KingBBQ/searchwingDronebuldingDoc/maintenance/hardware.md

# Hardware

## Motor

## Propeller

## Battery
