KingBBQ/searchwingDronebuldingDoc/using-the-drone/after-flight.md

# After-Flight

## 1. Download Images

After the plane is landed, you should immediatly start downloading the images to the groundstation laptop through the image download station.

1. Start by pressing "Download Drone images" on Groundstation Laptop
2. Enter dronename - here "perlman"
3. Leave cam prefix empty
4. Two windows should appear - each for one camera / pi in the plane
5. Approximatly 1 image download should take 1-2 seconds.

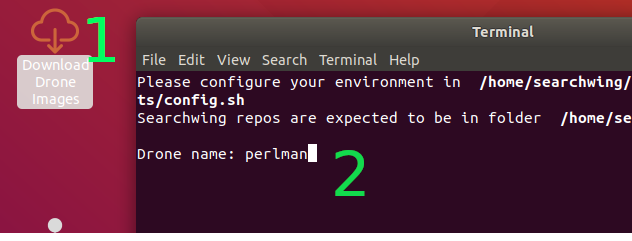
[picture p17: .gitbook/assets/image (8).png]


## 2. Image analysis

While image download is running, start analysis of the images while they get downloaded.

* There are different algorithms available to analyse the images 
  * Classify Images: Shows whether a image includes a boat but not where it is
    * EfficientNet
  * Detect Boats: Shows where in the image a boat is located
    * FRCNN
    * RetinaNet

{% hint style="info" %}
Be aware that only one analysis run / algorithm can run at a time - please close all open old analysis runs!
{% endhint %}

### Start analysis

1. Start analysis by clicking the corresponding desktop icon
2. Choose the currently downloaded images of the plane according to planename and timestamp from _/home/searchwing/flightdata/_
3. Press "OK"
4. All current and live added images to the folder will now be processed
5. Current progress and left over time can be observed

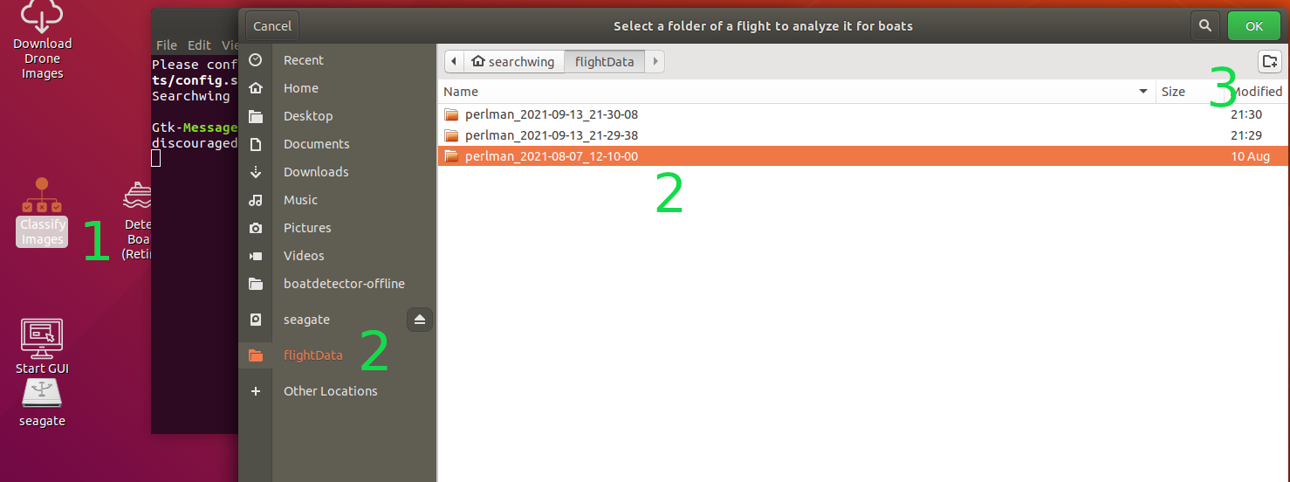
[picture p18: .gitbook/assets/image (16).png]


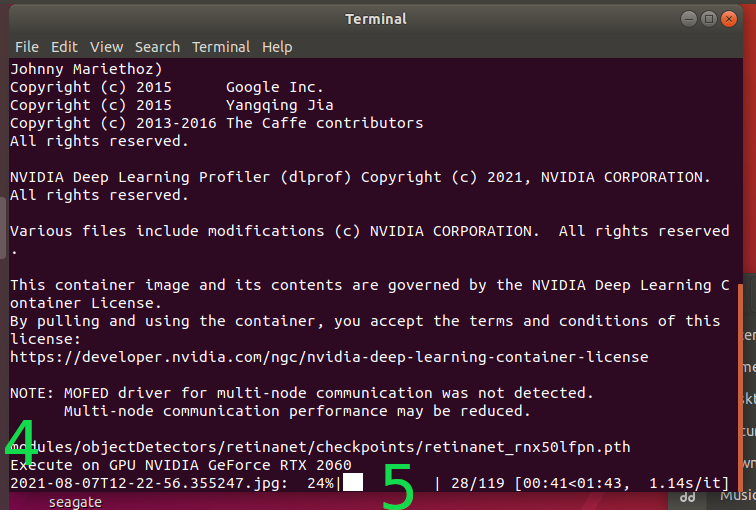
[picture p19: .gitbook/assets/image (12).png]


### Suggestion on how to process on new flight data \(Best practice!\)

1. Start "Image Classification" as it is the fastest algorithm
2. Wait until Download and classification is finished and close "Image Classification" 

   window

3. Start "Detect Boats \(Retina\)" as its more accurate than classification but takes longer

## 3. Observe images

While the download and the analysis is running you should now observer the images and the analysis results by using the searchwing-gui.

1. Start GUI via desktop icon - The browser should open
2. Select / click the currently downloaded image data
3. Read "Help" to get more usability info

   1. Use Arrowkeys to browse images
   2. Sort images using "DateTime" or "Algorithm"
   3. Press "Shift"-Key to temporarily hide Analysis Run Boxes
   4. Press "Enter"-Key to mark image as viewed and go to next image
   5. Press "Space"-Key to mark image as interesting / that there is REALLY a boat
   6. Current GPS Position is shown in the top bar
   7. Press "&lt;back" to choose a different flight dataset

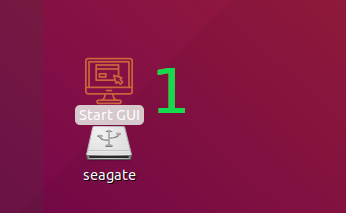
[picture p20: .gitbook/assets/image (7).png]


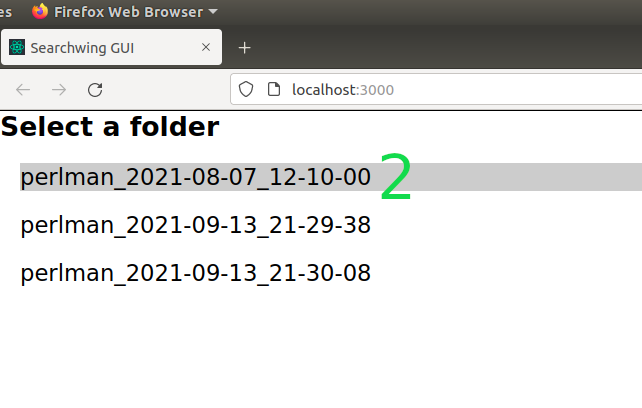
[picture p21: .gitbook/assets/image (9).png]


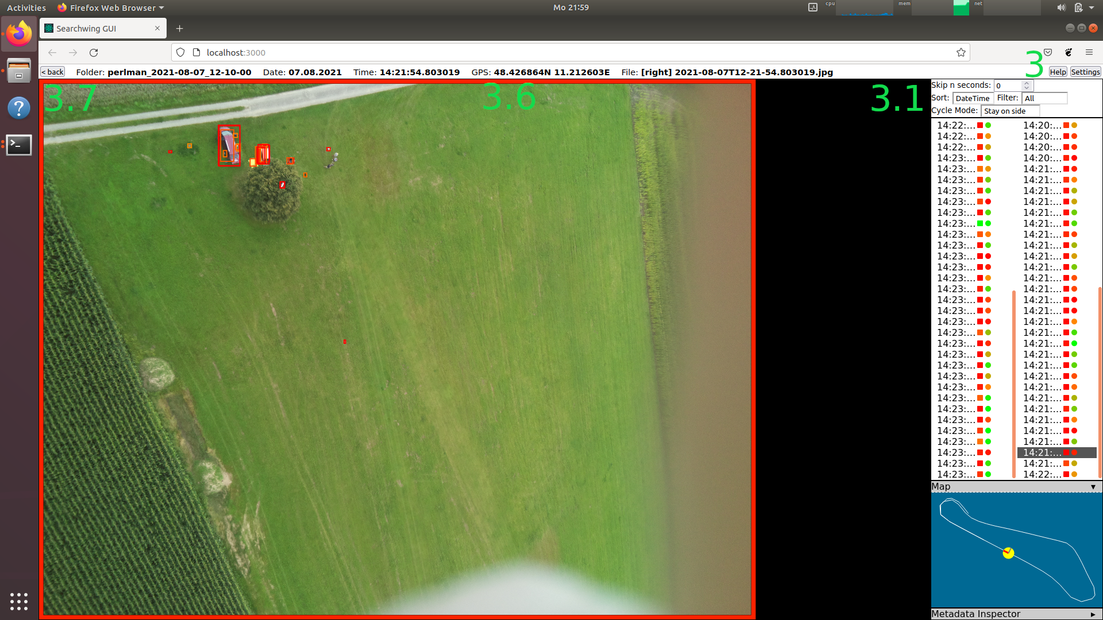
[picture p22: .gitbook/assets/image (14).png]


{% hint style="info" %}
If the GUI is already running and you try to open it up again a message will appear wheather you want to open the GUI at another port. Dont press "Y" but instead open the browser and open the GUI via typing in "localhost:3000".
{% endhint %}

## 4. Recharge Battery

* [ ] Plug in charging cable
* [ ] Use predefined setting for the drone

## \(optional\) Download pi log file

* [ ] Download the pi log file\(s\) via scp

```bash
$ mkdir -p /home/searchwing/flightdata/FLIGHTNAME/pi-logs
$ cd /home/searchwing/flightdata/FLIGHTNAME/pi-logs
$ scp searchwing@perlman-l:/data/logs/* .
```

## 5. Turn off systems

* [ ] UAV / drone
* [ ] Remote control
* [ ] QGC / tablet
* [ ] TODO

## 6. Documentation

* [ ] Get flight log / book
* [ ] Is goal reached?
* [ ] TODO

## \(optional\) Cleaning the drone

{% hint style="info" %}
If drone is not used anymore within the next hours cleaning is needed!
{% endhint %}

### Clean motor using sweetwater

* TODO
