KingBBQ/searchwingDronebuldingDoc/.gitbook/assets/bending_tube_wires.jpeg

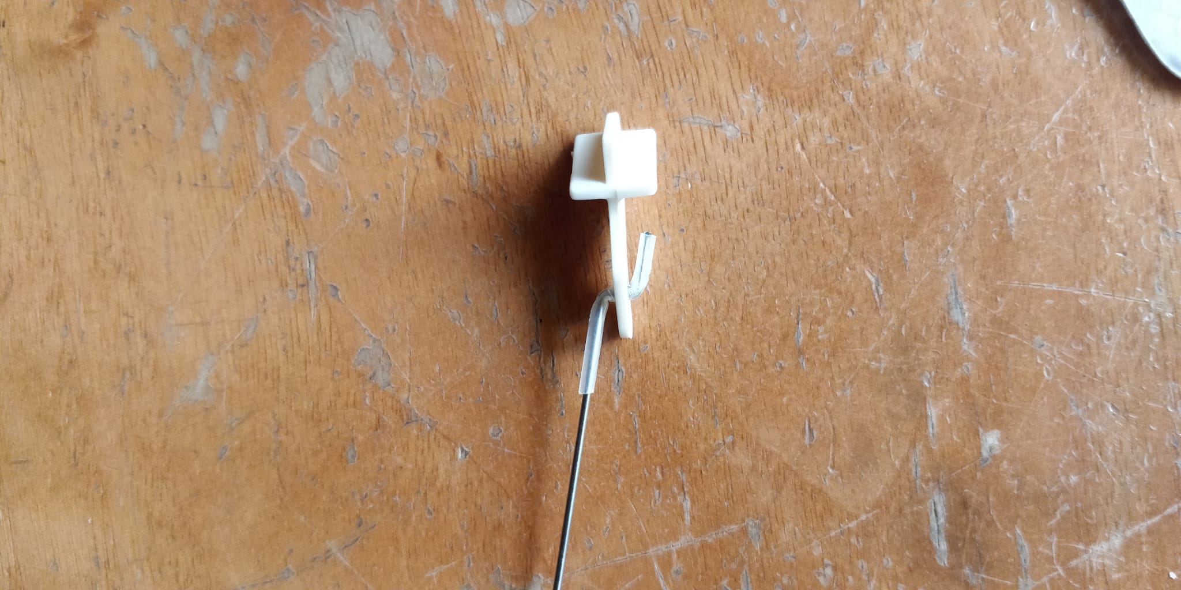
.gitbook/assets/bending_tube_wires.jpeg
