KingBBQ/searchwingDronebuldingDoc/.gitbook/assets/cutting_vtail.jpeg

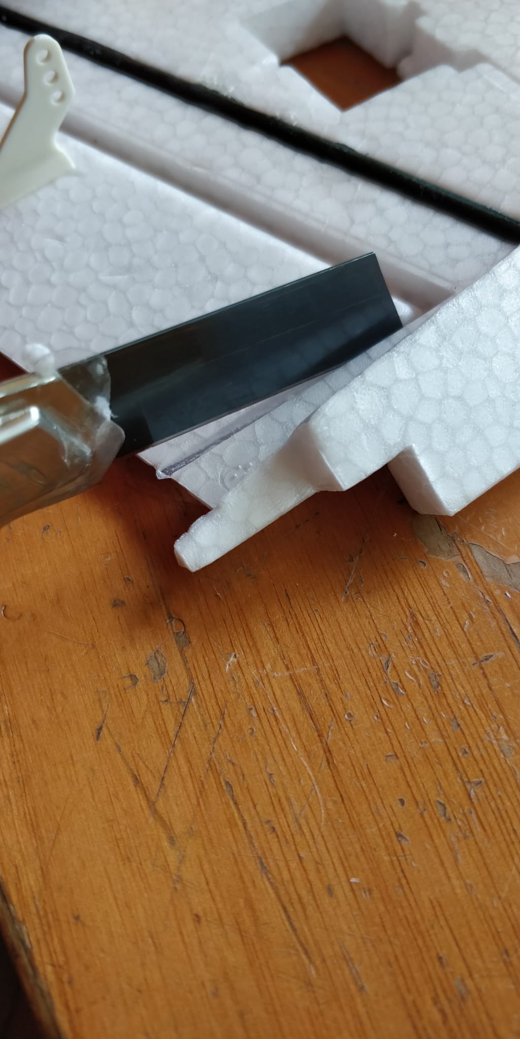
.gitbook/assets/cutting_vtail.jpeg
