KingBBQ/searchwingDronebuldingDoc/.gitbook/assets/gps_tower_1 (1).jpeg

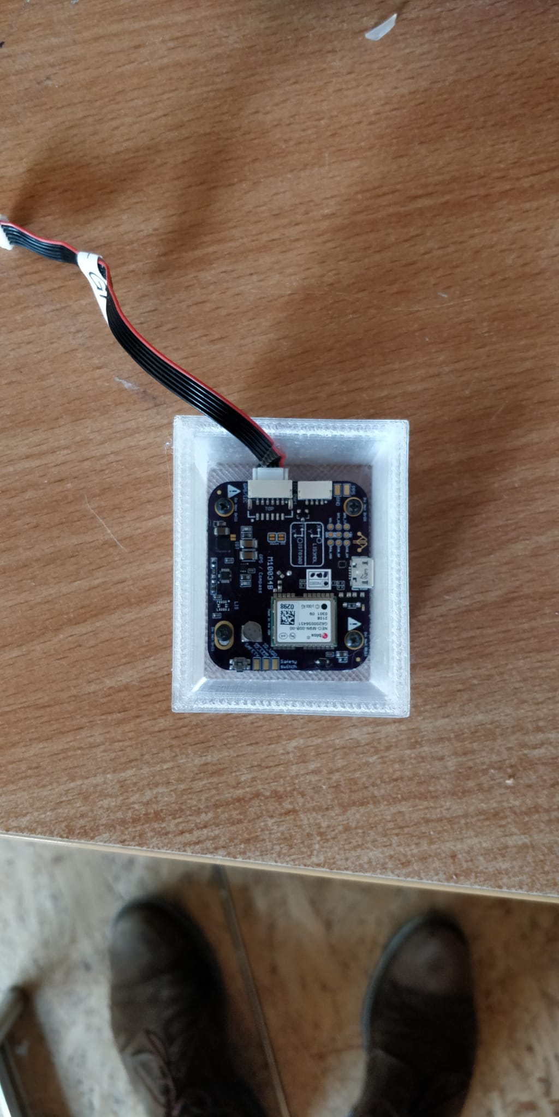
.gitbook/assets/gps_tower_1 (1).jpeg
