KingBBQ/searchwingDronebuldingDoc/.gitbook/assets/gps_tower_4.jpeg

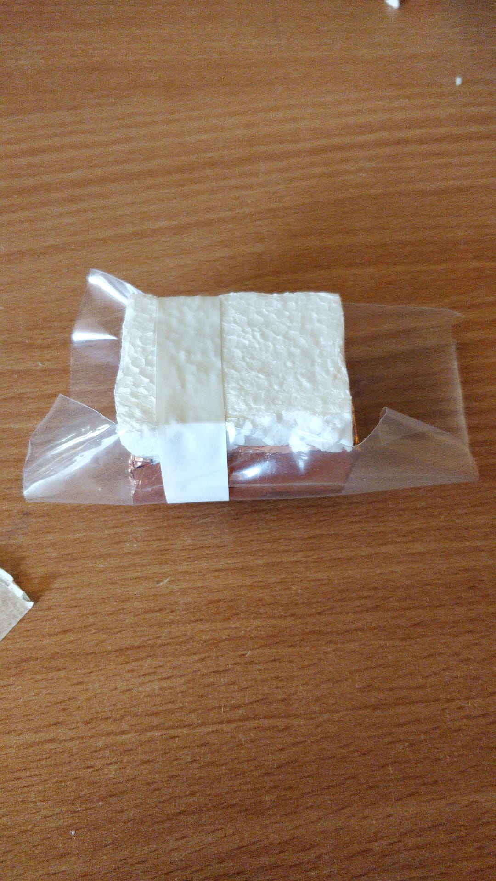
.gitbook/assets/gps_tower_4.jpeg
