KingBBQ/searchwingDronebuldingDoc/.gitbook/assets/image (17).png

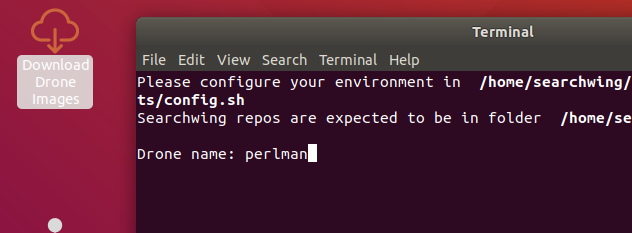
.gitbook/assets/image (17).png
