KingBBQ/searchwingDronebuldingDoc/.gitbook/assets/img_20210607_140835.jpg

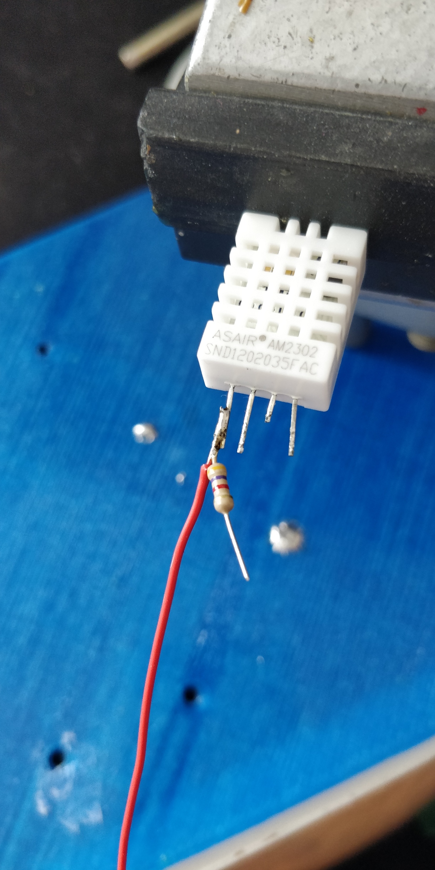
.gitbook/assets/img_20210607_140835.jpg
