KingBBQ/searchwingDronebuldingDoc/.gitbook/assets/img_20210607_141408.jpg

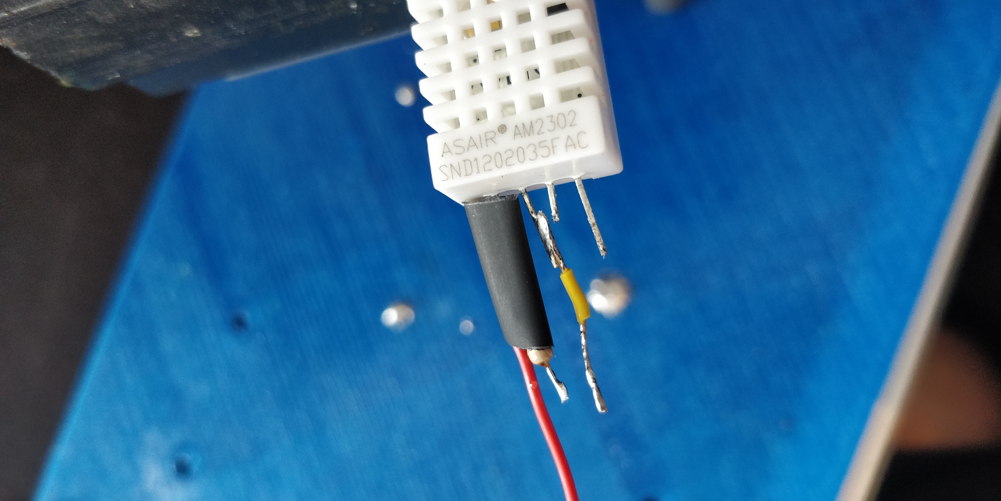
.gitbook/assets/img_20210607_141408.jpg
