KingBBQ/searchwingDronebuldingDoc/.gitbook/assets/img_20210607_141638.jpg

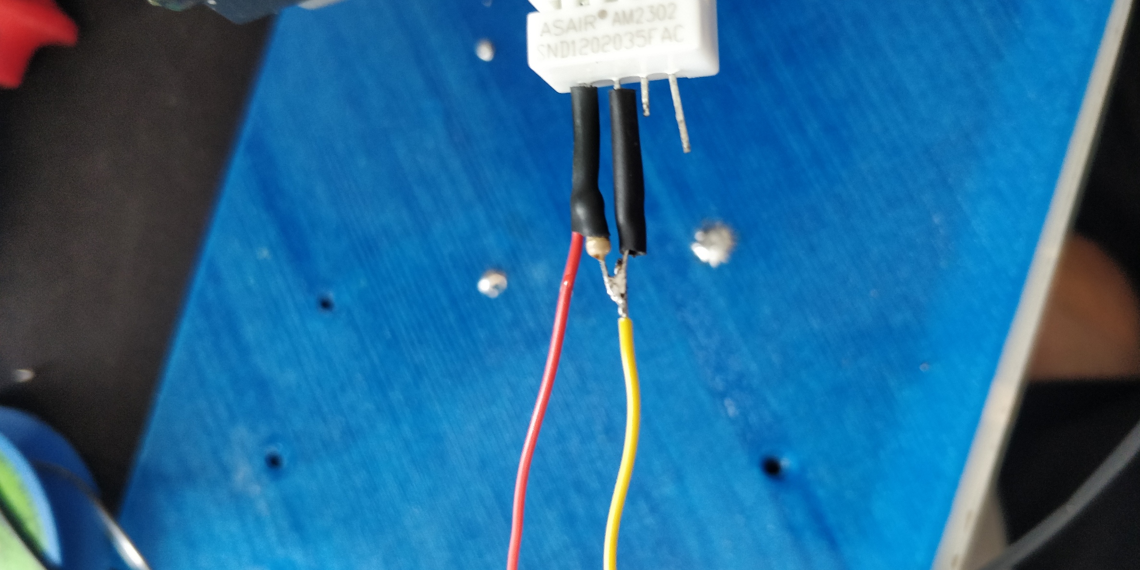
.gitbook/assets/img_20210607_141638.jpg
