KingBBQ/searchwingDronebuldingDoc/.gitbook/assets/img_20210607_142049.jpg

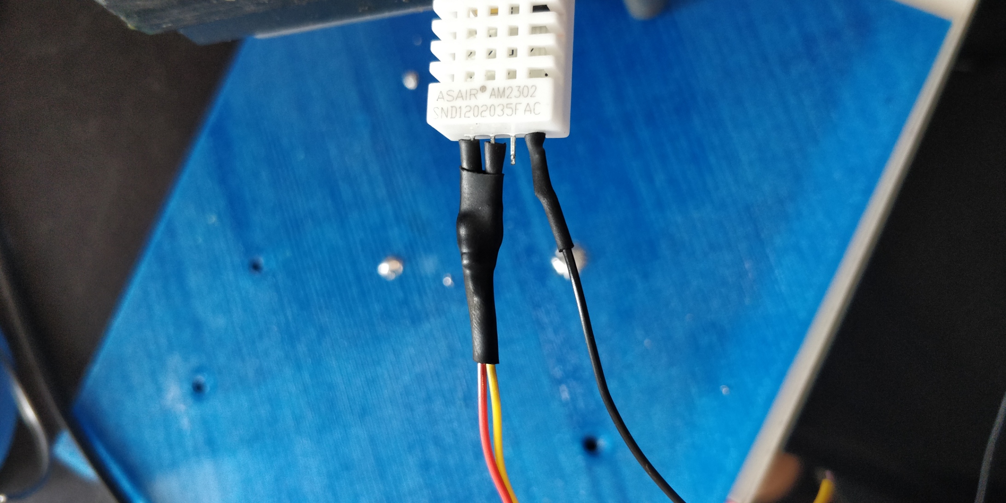
.gitbook/assets/img_20210607_142049.jpg
