KingBBQ/searchwingDronebuldingDoc/Photos/Cables/PowerModule 4.jpg

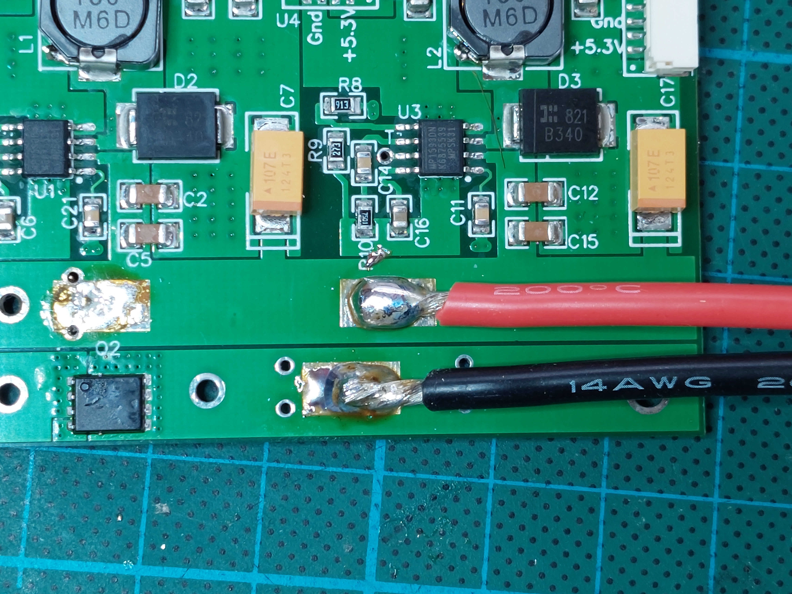
Photos/Cables/PowerModule 4.jpg
