KingBBQ/searchwingDronebuldingDoc/Photos/Schematics/PixRacer.png

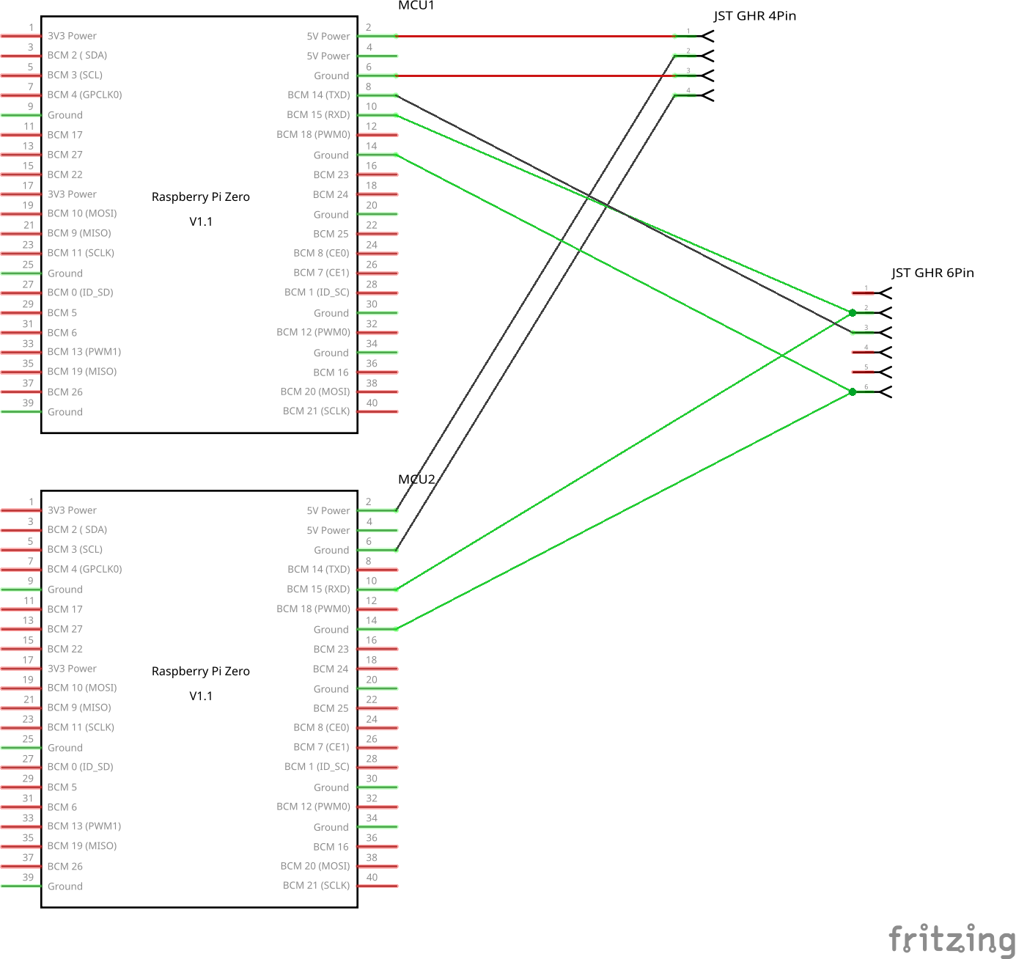
Photos/Schematics/PixRacer.png
