KingBBQ/searchwingDronebuldingDoc/preparing-components/combining-components/equipping-the-box-with-all-components.md

# Equipping the box with all components

#### Time required

* **Building:** 1 hour
* **Curing**: 2 days

#### Tools required

* Loctice 243
* 9mm wrench

#### Parts required

* all elecronic parts
* front and back of box
* cover for box
* screws 1.7mm x 4mm for camera
* ... 2.2mm x 6.5 for everything else
* Silicon 
* pen

## Step 1: Install the servo connectors



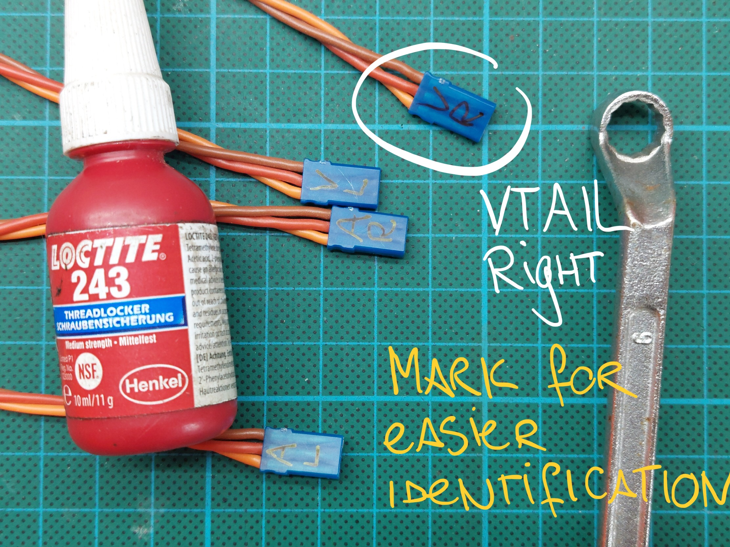
[picture p38: .gitbook/assets/m-plug-2.jpg]


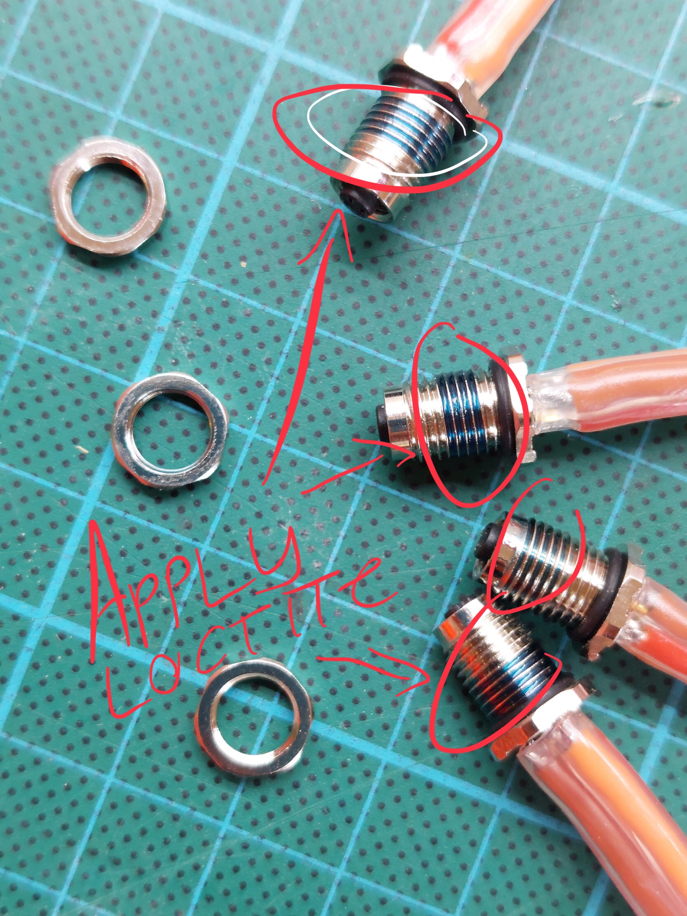
[picture p39: .gitbook/assets/m-plug-3.jpg]


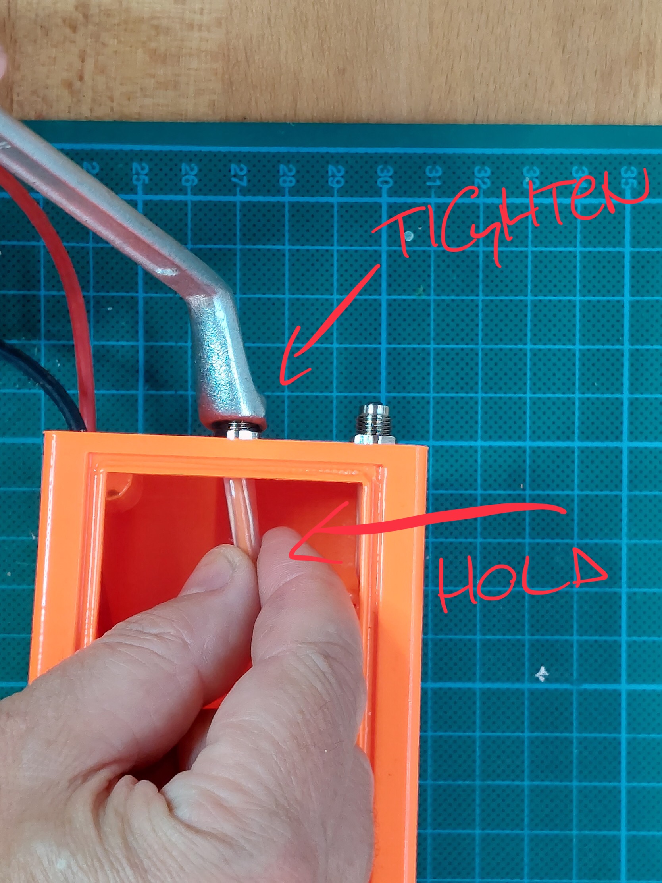
[picture p40: .gitbook/assets/m-plug-4.jpg]


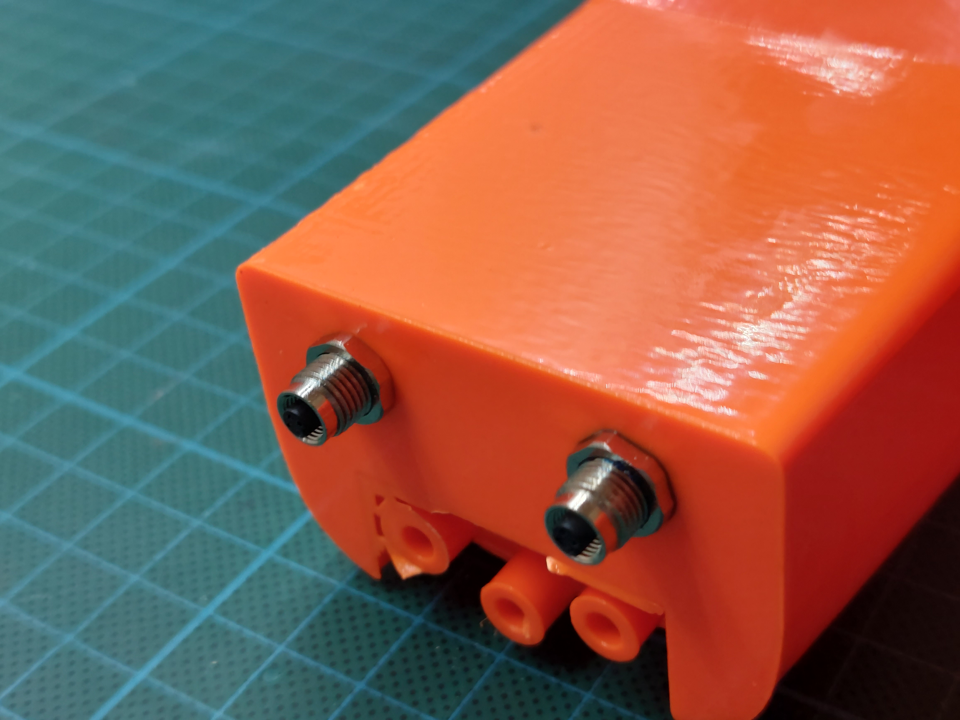
[picture p41: .gitbook/assets/m-plug-6.jpg]


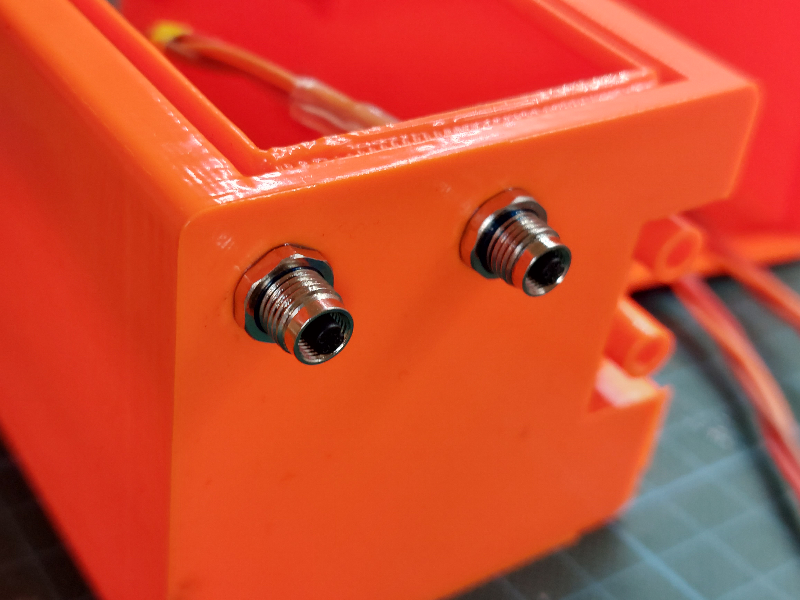
[picture p42: .gitbook/assets/m-plug-7.jpg]


{% hint style="info" %}
Give special instrucktion... 
{% endhint %}

## Step 2: Install Raspberry Pi and Camera

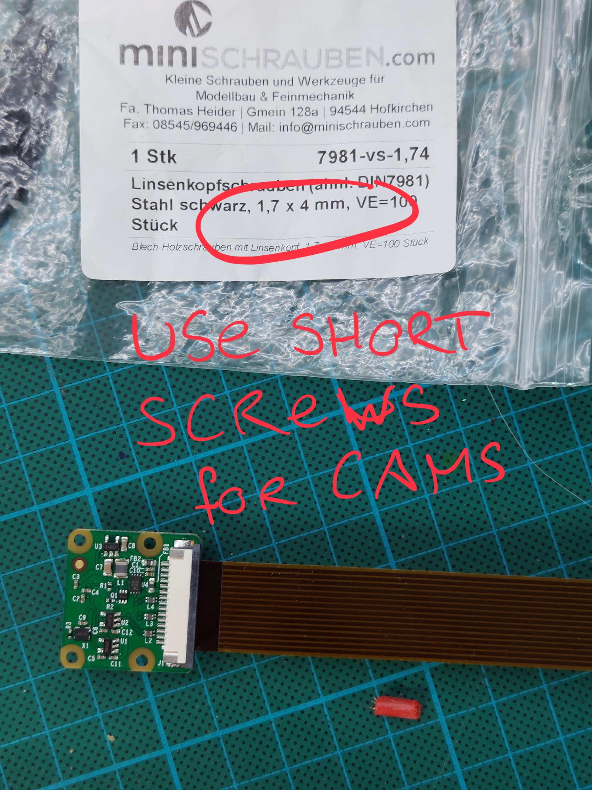
[picture p43: .gitbook/assets/picam-1.jpg]


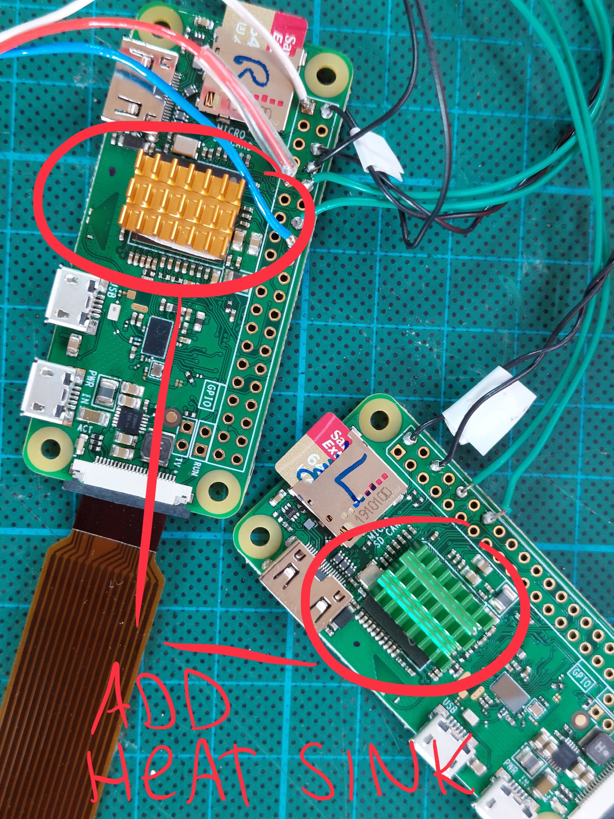
[picture p44: .gitbook/assets/picam-2.jpg]


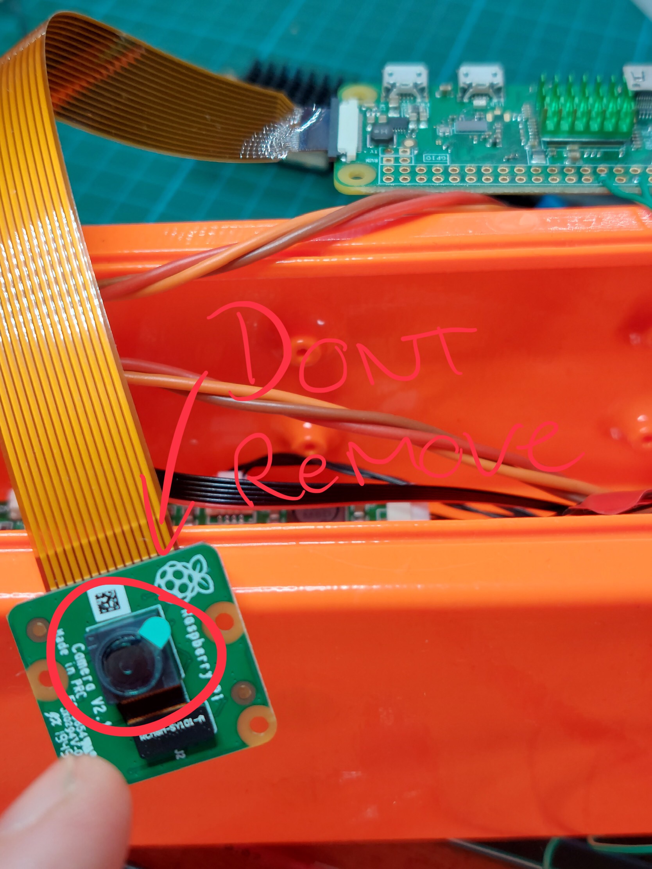
[picture p45: .gitbook/assets/picam-3.jpg]


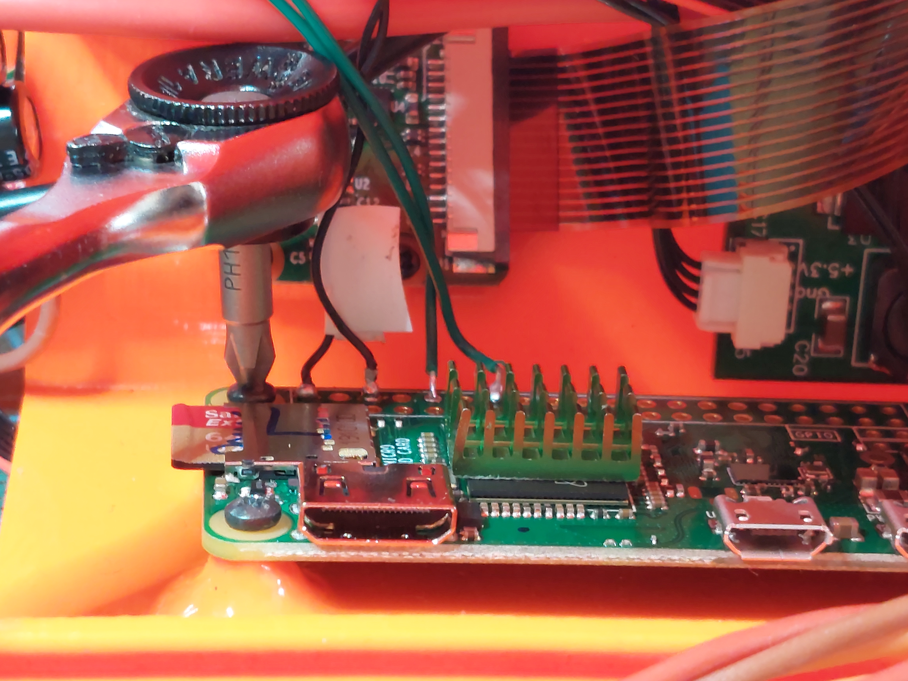
[picture p46: .gitbook/assets/picam-4.jpg]


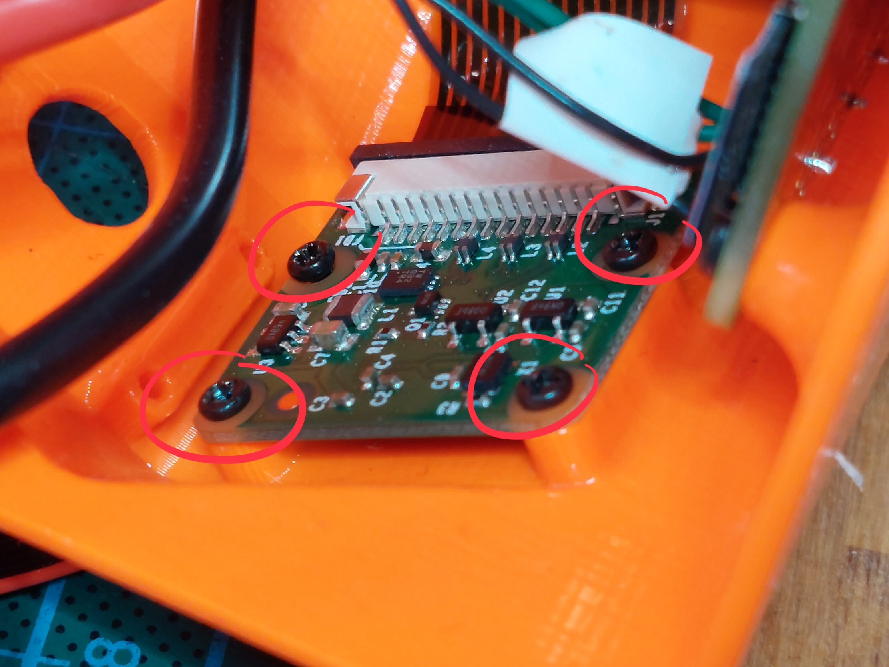
[picture p47: .gitbook/assets/picam-5.jpg]


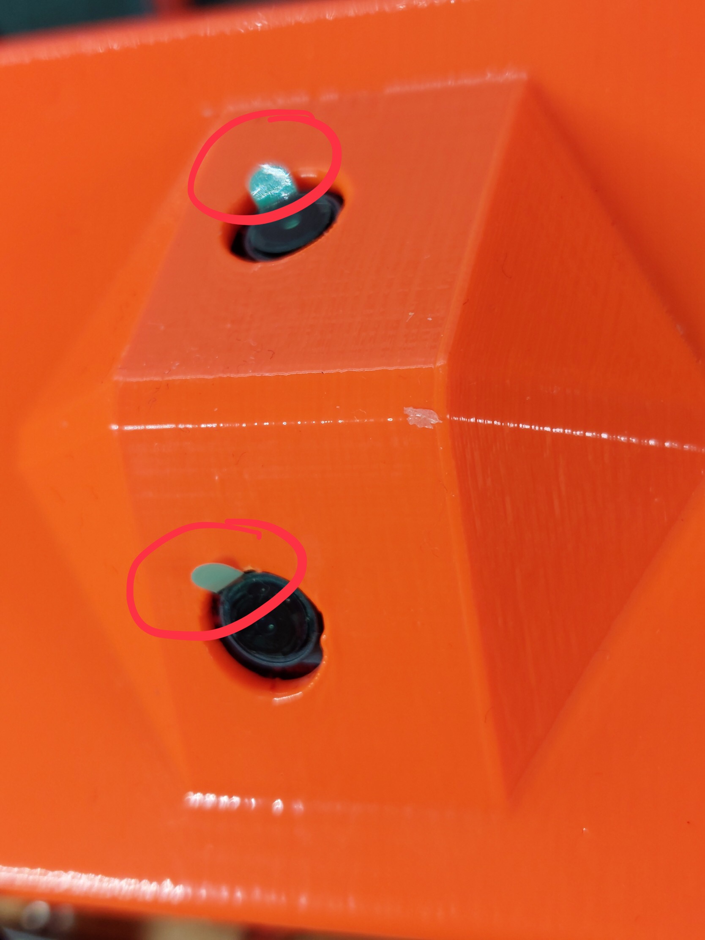
[picture p48: .gitbook/assets/picam-6.jpg]


## Step 3: Install the Power Module



## Step 4: Prepare the cover

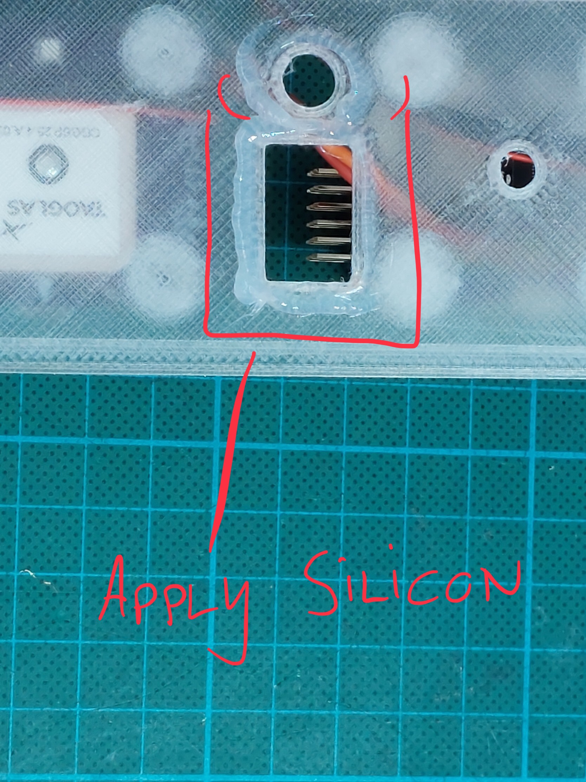
[picture p50: .gitbook/assets/cover-1.jpg]


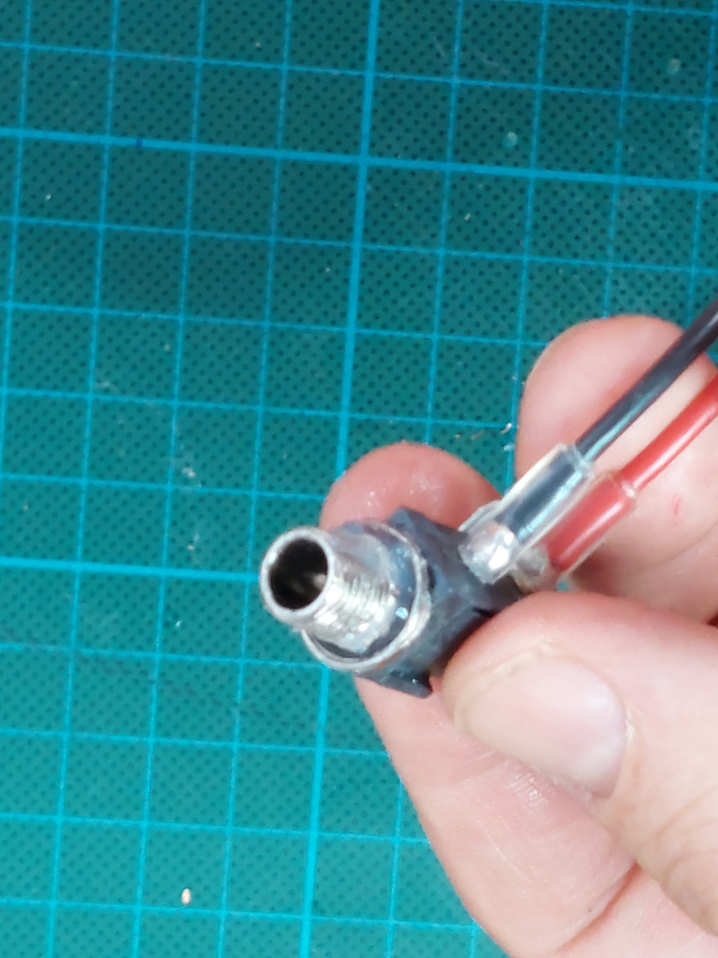
[picture p51: .gitbook/assets/cover-2.jpg]


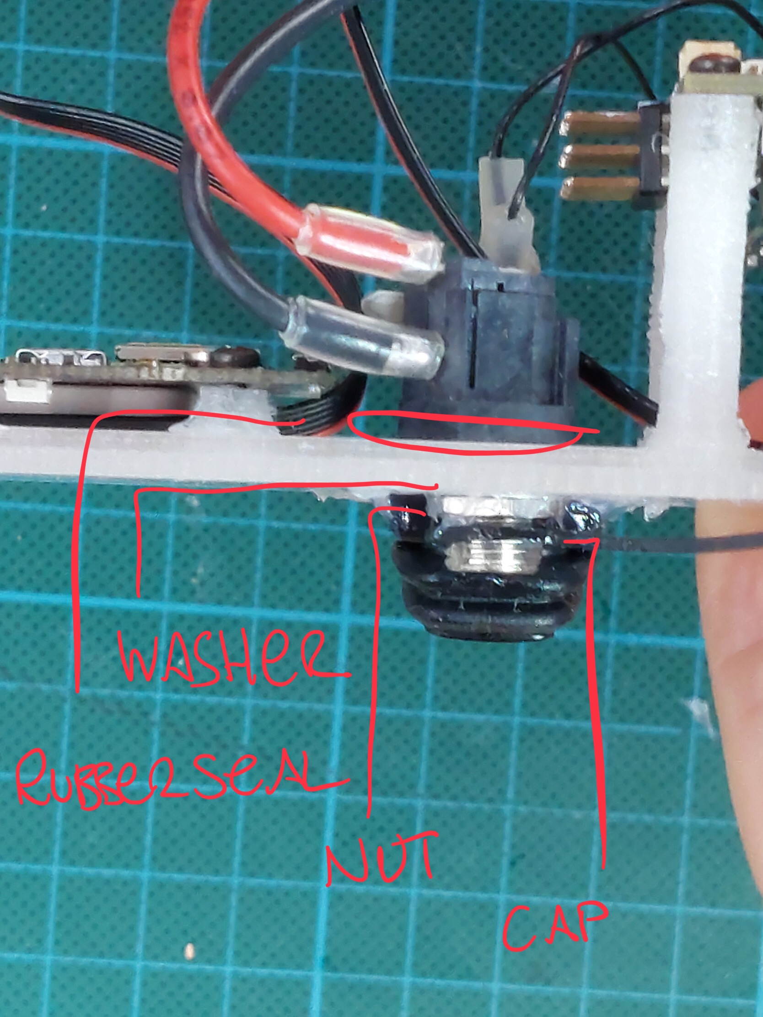
[picture p52: .gitbook/assets/cover-3.jpg]


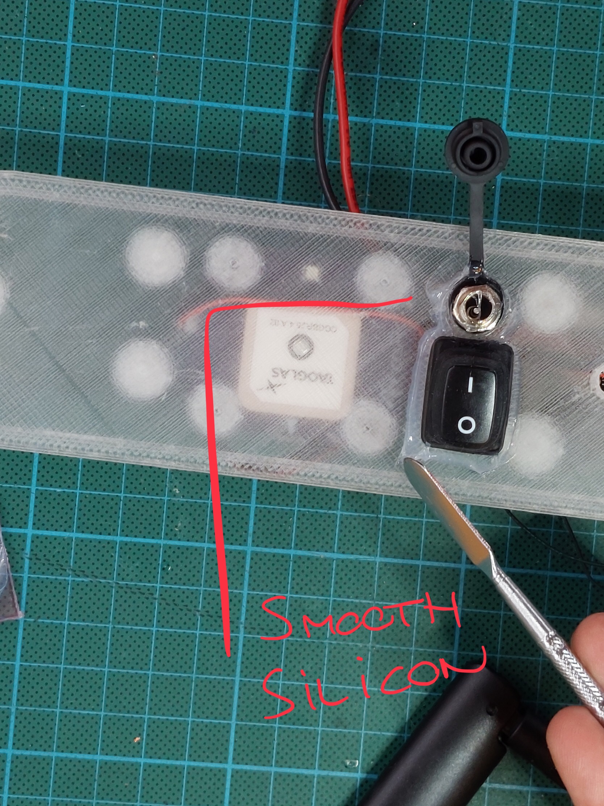
[picture p53: .gitbook/assets/cover-4.jpg]


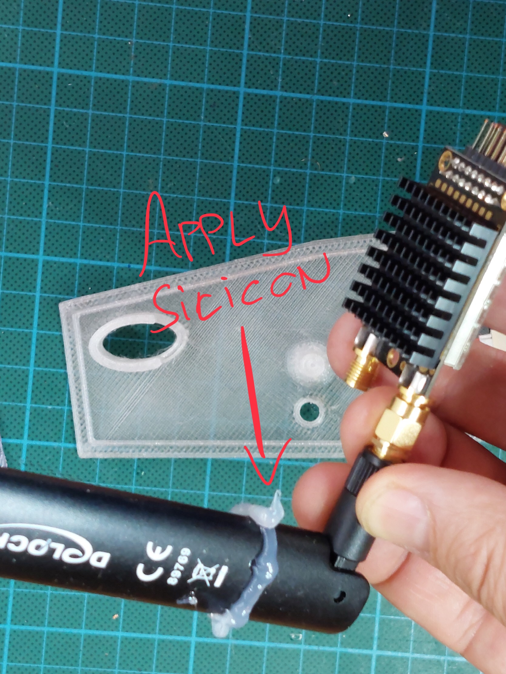
[picture p54: .gitbook/assets/cover-antenna-1.jpg]


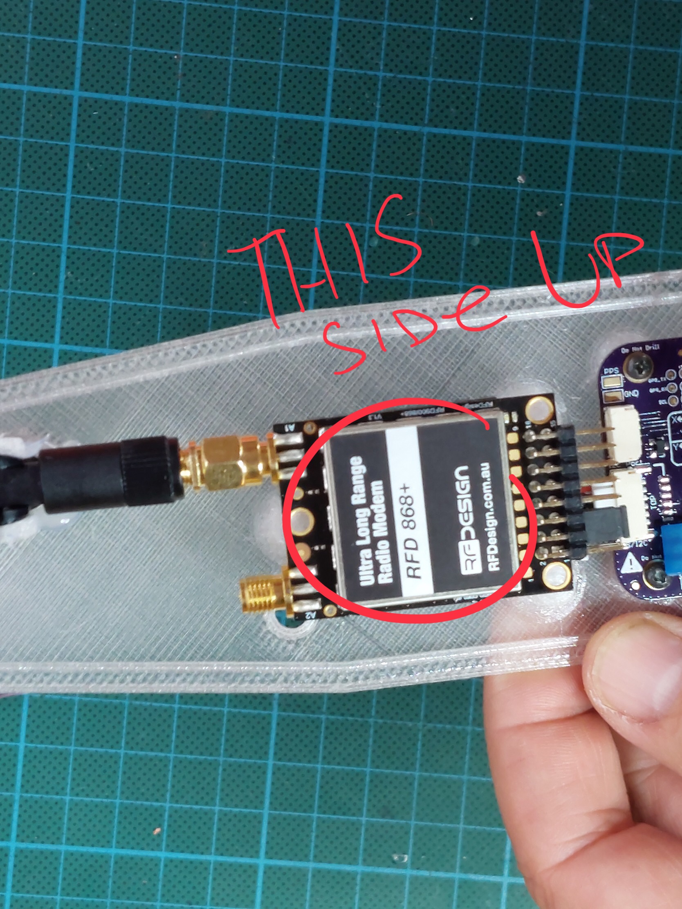
[picture p55: .gitbook/assets/cover-antenna-2.jpg]


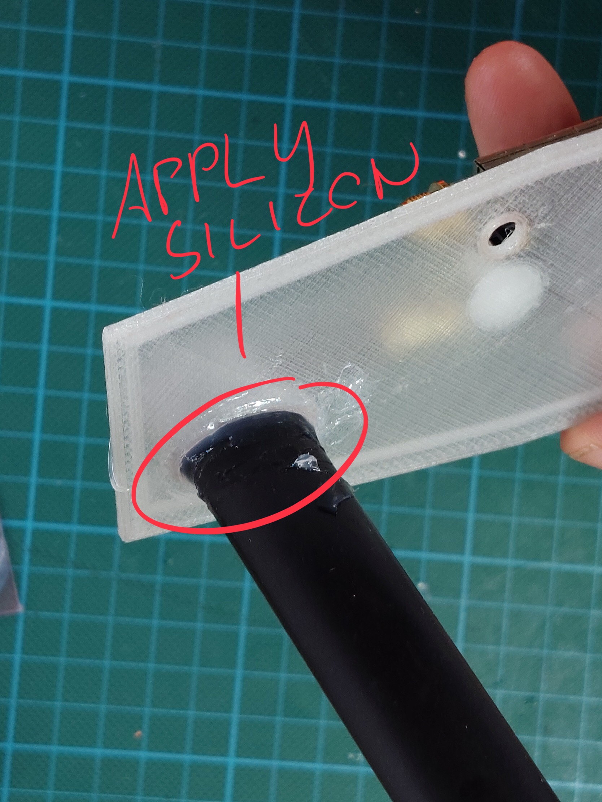
[picture p56: .gitbook/assets/cover-antenna-4.jpg]


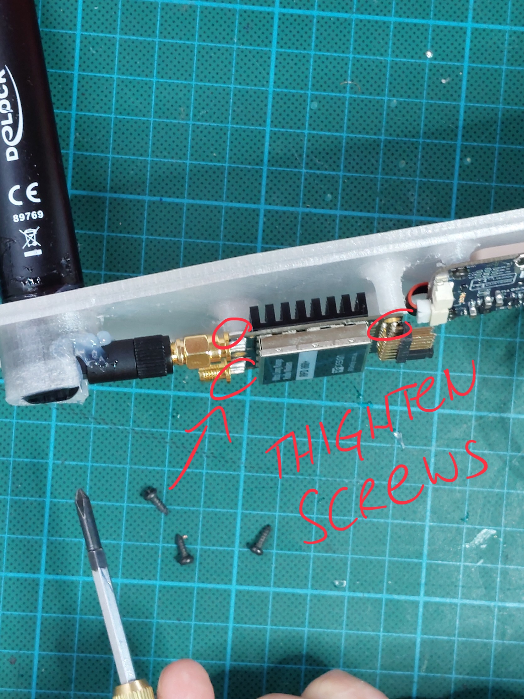
[picture p57: .gitbook/assets/cover-antenna-5.jpg]


## Step 4: Combining front and back

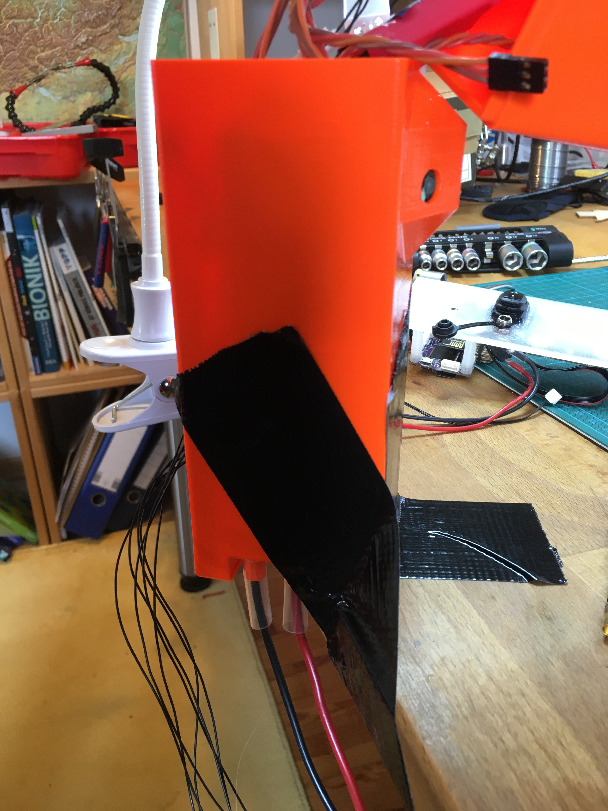
[picture p58: .gitbook/assets/box-combine-parts-1.jpg]


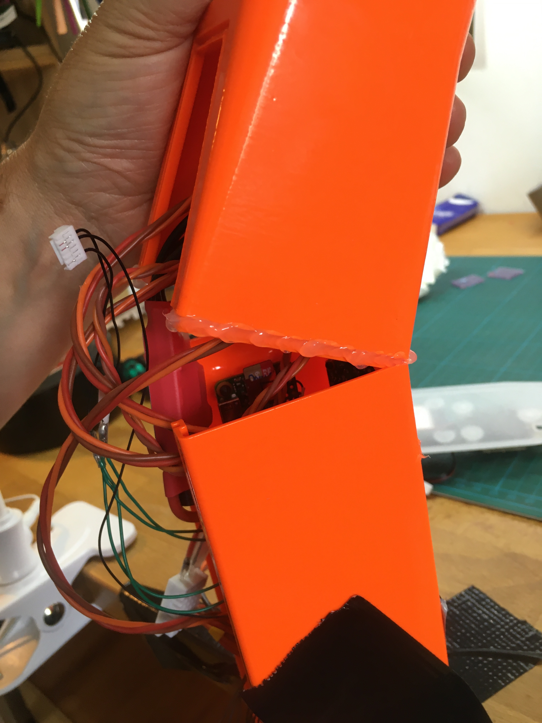
[picture p59: .gitbook/assets/box-combine-parts-2.jpg]


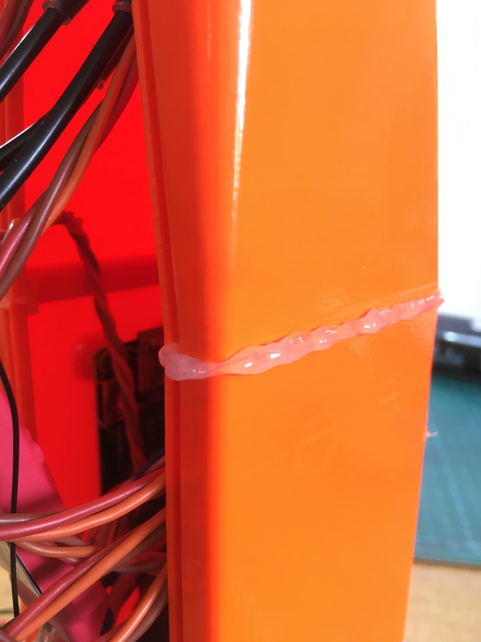
[picture p60: .gitbook/assets/box-combine-parts-3.jpg]


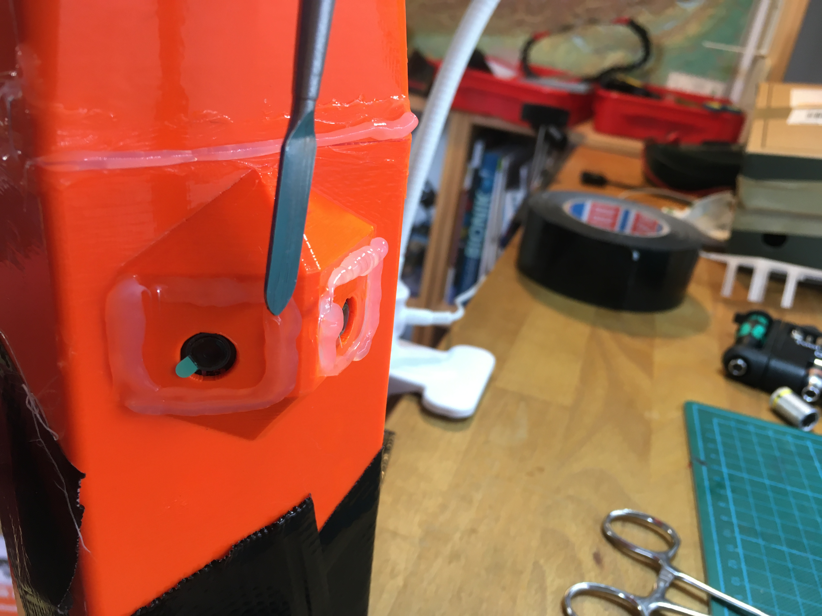
[picture p61: .gitbook/assets/box-combine-parts-4.jpg]


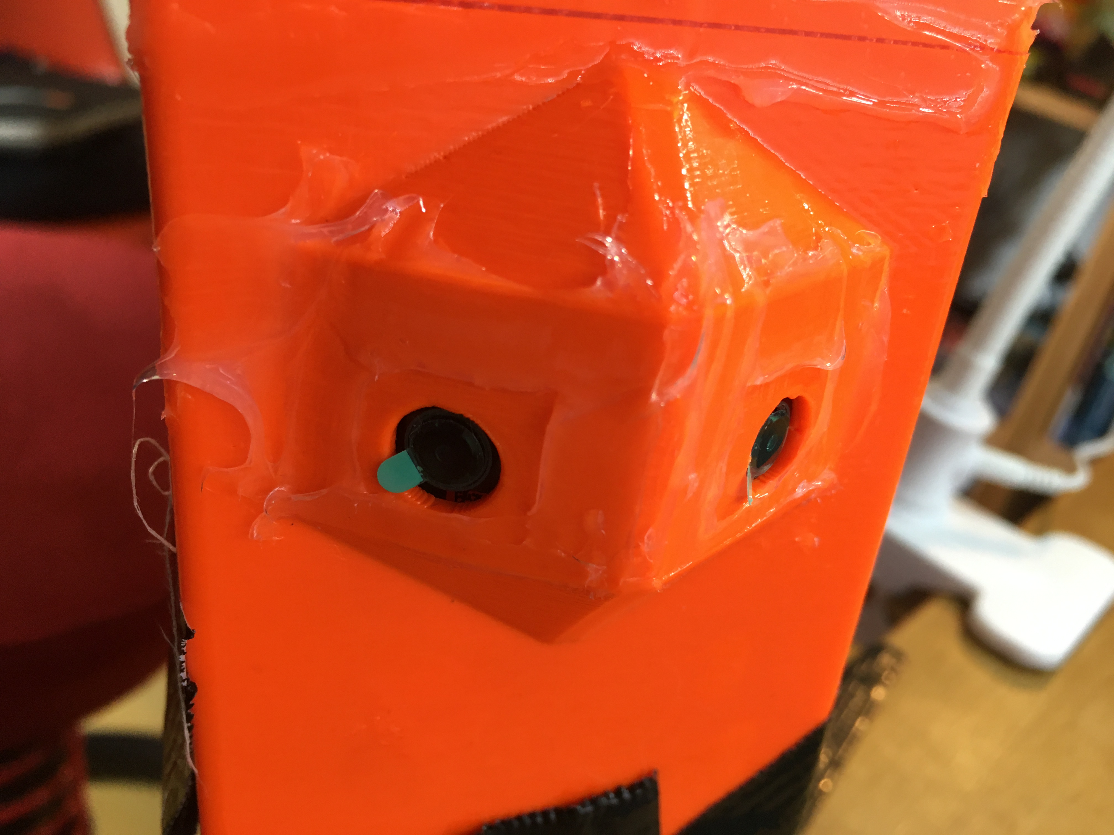
[picture p62: .gitbook/assets/box-combine-parts-5.jpg]


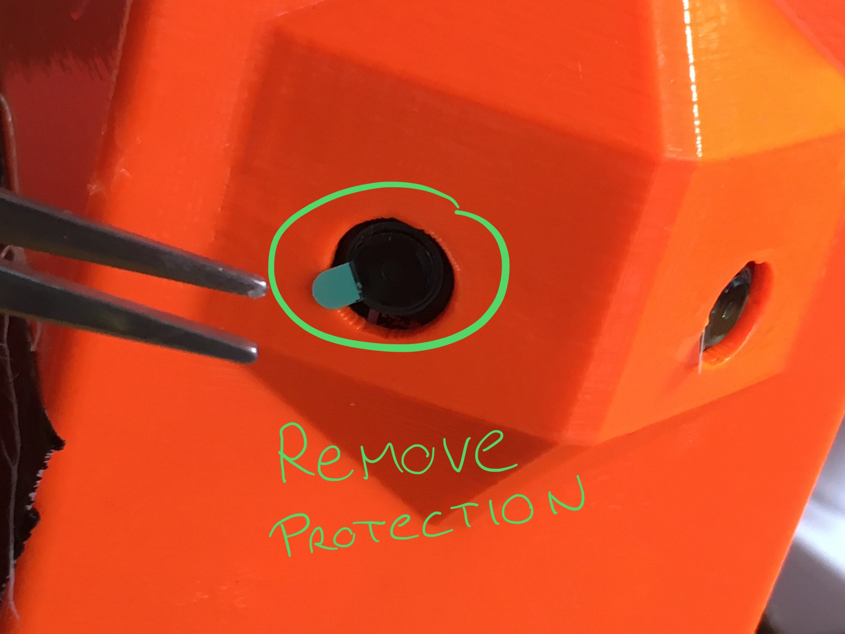
[picture p63: .gitbook/assets/box-combine-parts-6.jpg]


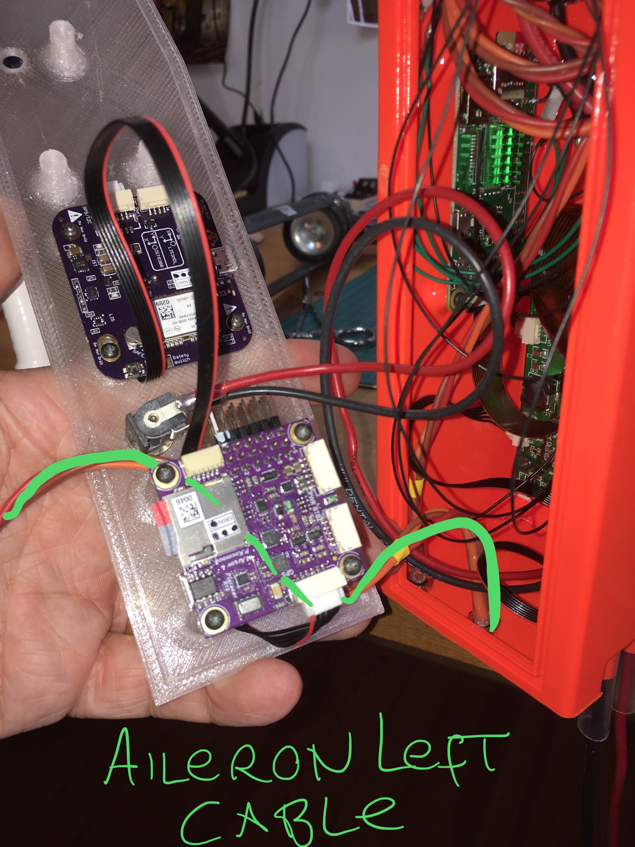
[picture p64: .gitbook/assets/box-combine-parts-7.jpg]


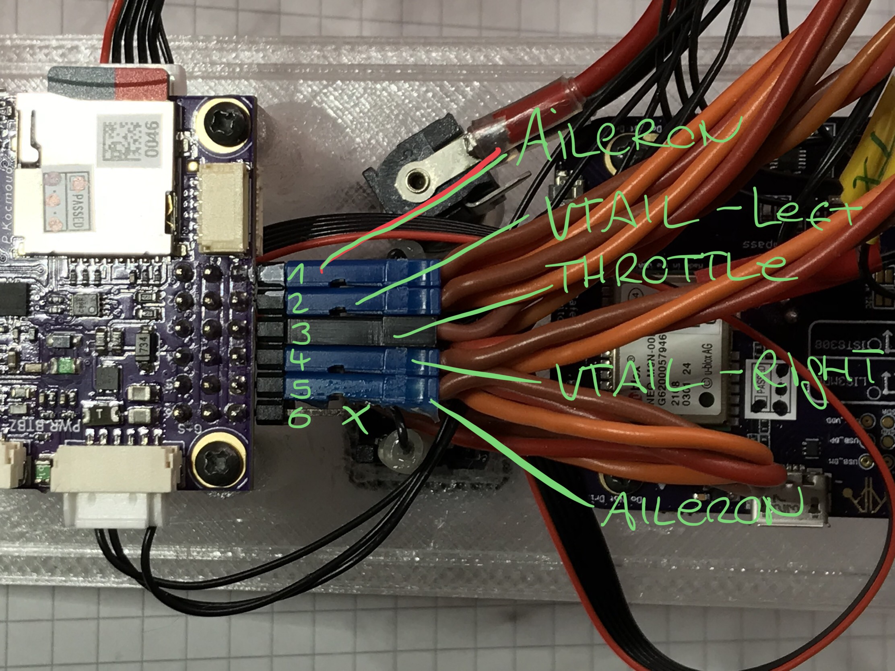
[picture p65: .gitbook/assets/pixracer-connections-servo (1).jpg]


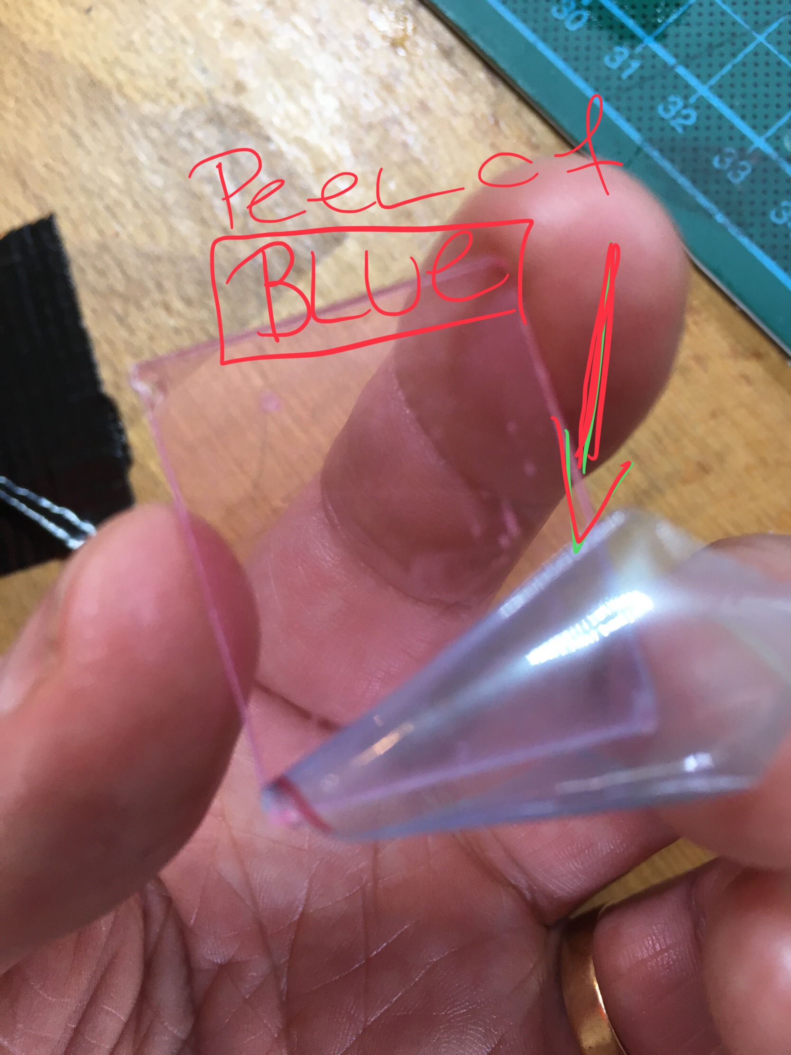
[picture p66: .gitbook/assets/box-combine-parts-8.jpg]


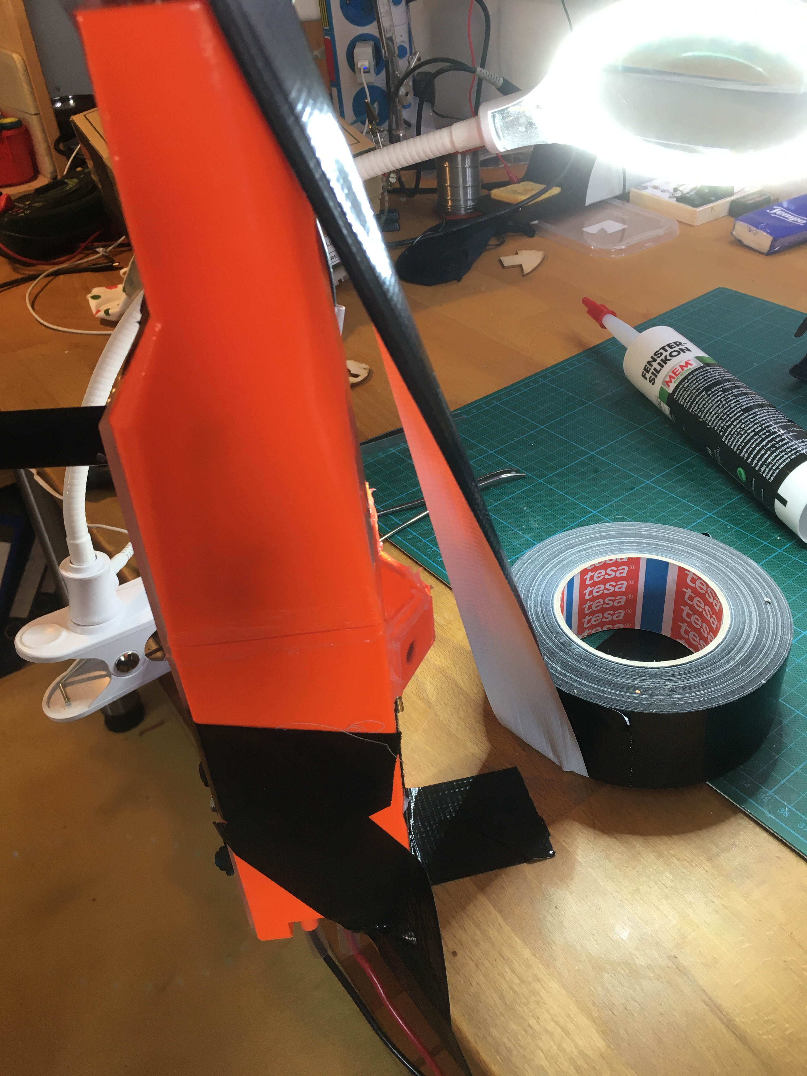
[picture p67: .gitbook/assets/box-combine-parts-9.jpg]


## Connecting all the cables

#### Servo Cables

Connection of the servo and ESC Cables to the flight controller

* Brown \(GND\) "up" \(away from cover\)
* Aileron left & right are "identical" - doesnt matter, which is connected to 1 / 5
* Connection 6 is left empty

## Finalization & Testing

* [ ] * [ ] and that...
