KingBBQ/searchwingDronebuldingDoc/preparing-components/generic-componets/equipping-the-power-board.md

# ??? Equipping the power board

#### Time required

* **Building:** 30 minutes

#### Tools required

* 
#### Parts required

* Extron Motor
* Bearing
* Bearing

## Finalization & Testing

* [ ] check this
* [ ] and that...
