KingBBQ/searchwingDronebuldingDoc/preparing-components/generic-componets/gps-tower.md

---
description: Building the GPS Tower
---

# GPS Tower

Screw in the GPS m9n Module. Direction doesn't matter. Case is symmetrical.

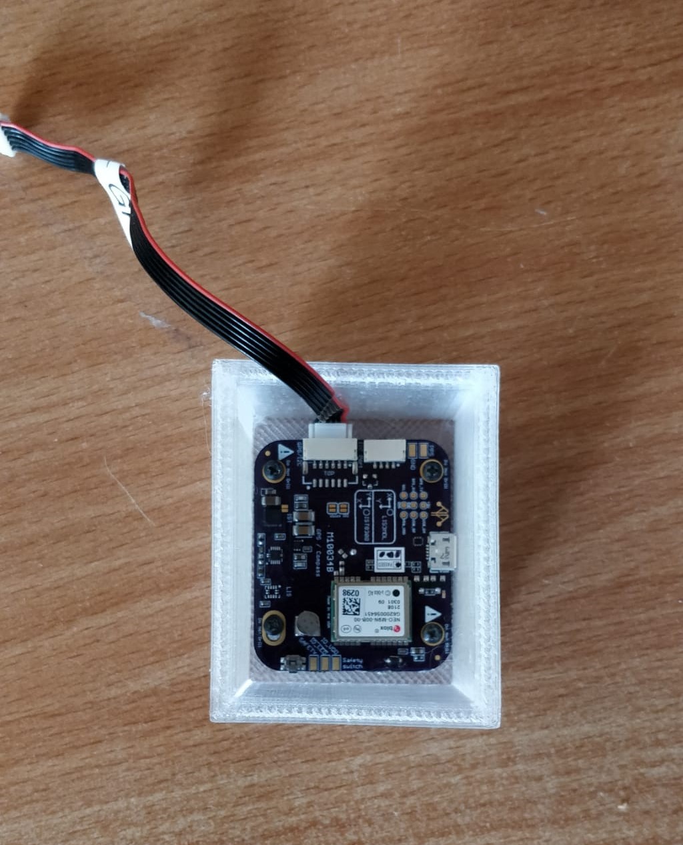
[picture p70: .gitbook/assets/gps_tower_1.jpeg]


Fit GPS cable through the hole in the cover and plug it in the designated port on the pixracer.

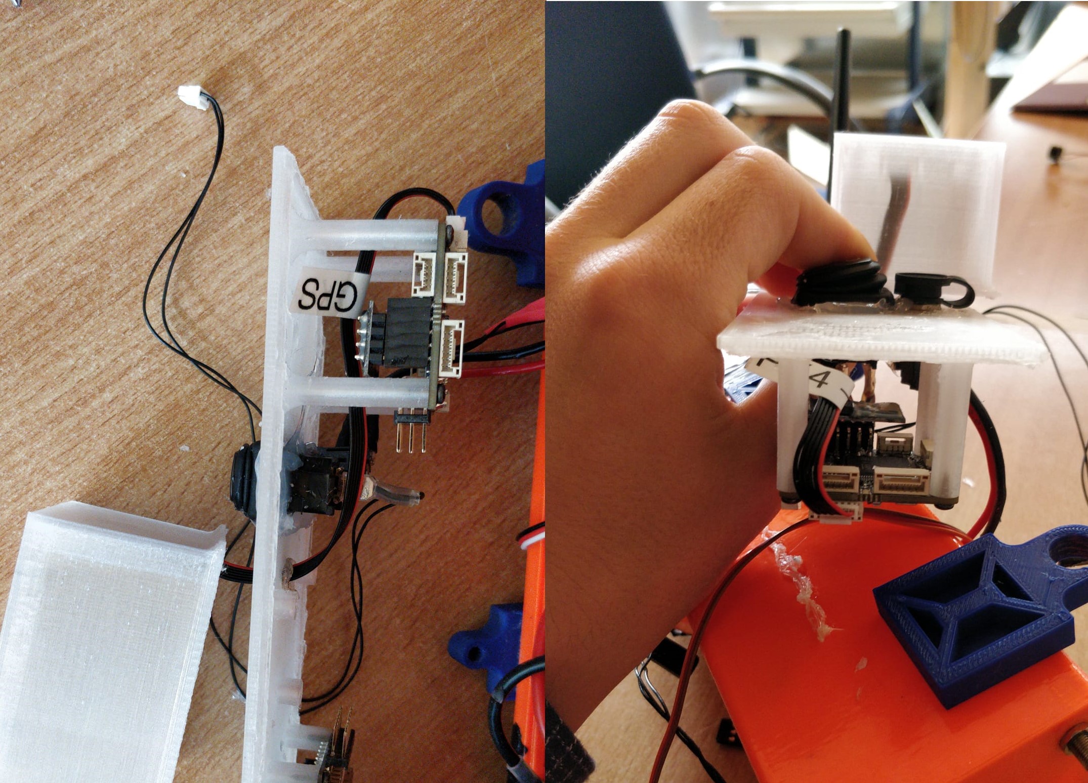
[picture p71: .gitbook/assets/gps_tower_2_1.jpeg]


#### Electromagnetic shielding

Prepare a styropor cube of the size: 50x40x30mm and cover the bottom side with Alu or Copper foil. 

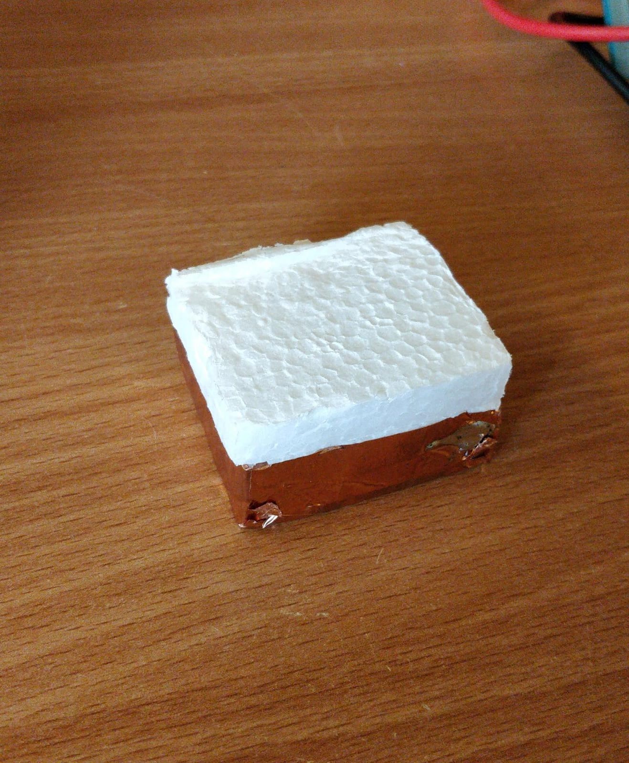
[picture p72: .gitbook/assets/gps_tower_3.jpeg]


To prevent short circuits wrap it with some plastic foil. 

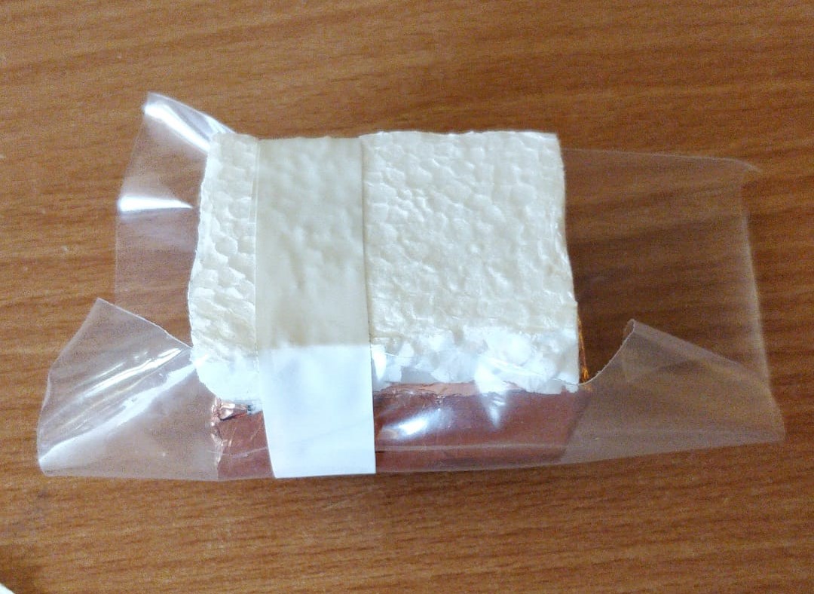
[picture p73: .gitbook/assets/gps_tower_4 (1).jpeg]


Here are some leftovers from the vacuum packages from the battery bag used.

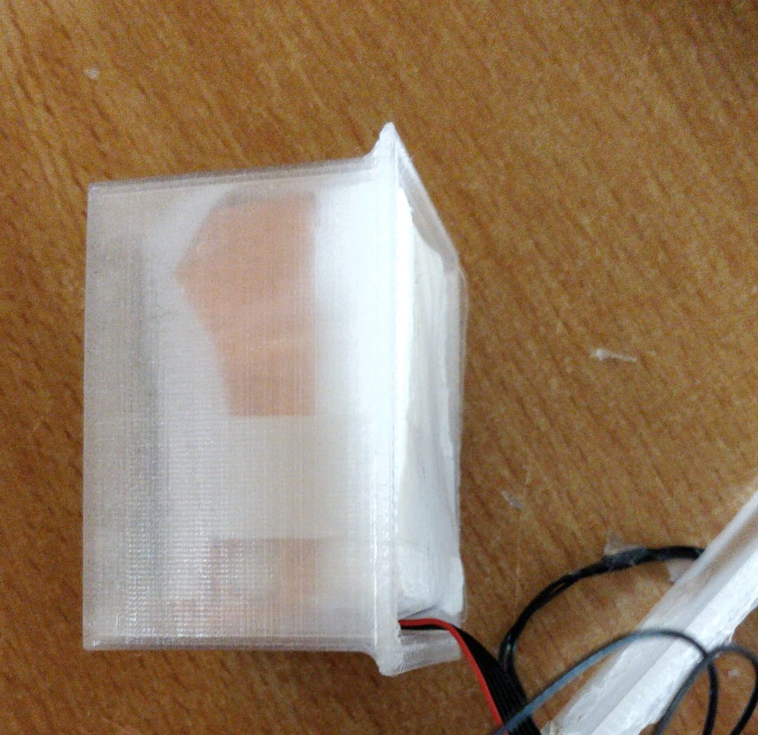
[picture p74: .gitbook/assets/gps_tower_5.jpeg]


Put the cube in the GPS tower.

#### GPS Test

Before glueing of the Tower check if the GPS gets an appropriate amount of Sattelite locks \(&gt;15 is good\).
