KingBBQ/searchwingDronebuldingDoc/preparing-components/combining-components/power-cables.md

# Power cables

#### Time required

* **Building:** 30 minutes

#### Tools required

* Soldering iron
* Heatgun

#### Parts required

* Powermodule
* Powercable \(3mm diameter\)
* Shrink tubing
* ESC Pigtails for motor connection

## Prepare Power Module

* Presolder the following soldering pads for the upcoming steps

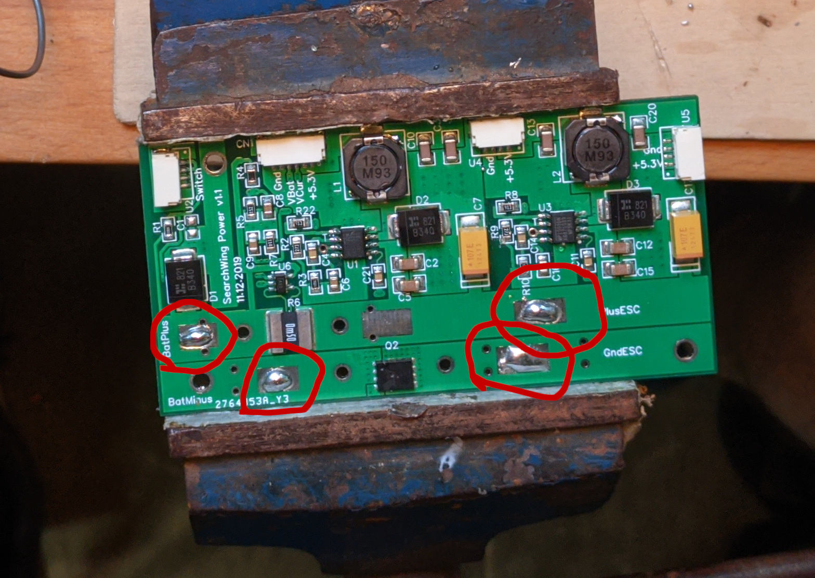
[picture p75: .gitbook/assets/prepare_powermodule.jpg]


## Battery -&gt; Power Module

* Cut a 20cm piece of power cable \(red and black\) - long enough that the battery connctor outside can be connected
* Remove 3mm of isolation on both sides
* Presolder the wires
  * The whole cable should be covered with solder

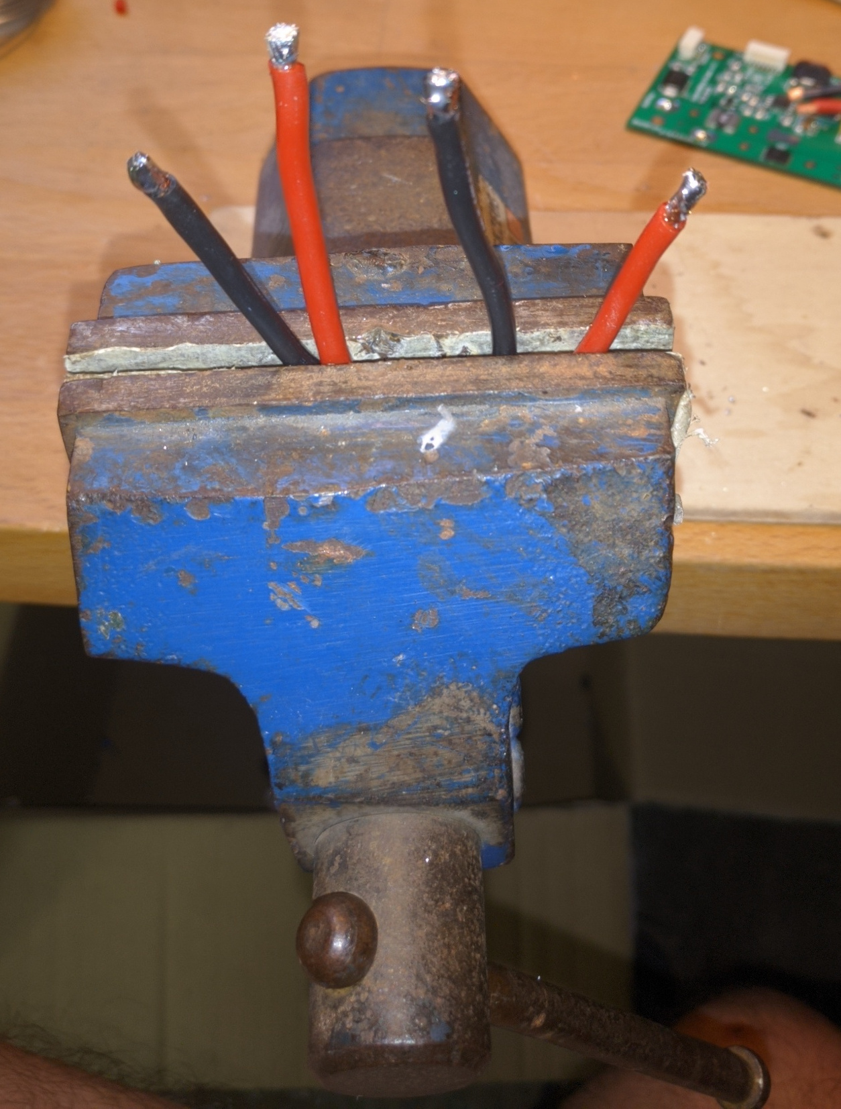
[picture p76: .gitbook/assets/presolder_powercables.jpg]
Presolder the open ends of the cables


* Solder the Cables to the corresponding spots on the power module
  * Check your solderings by pulling at them

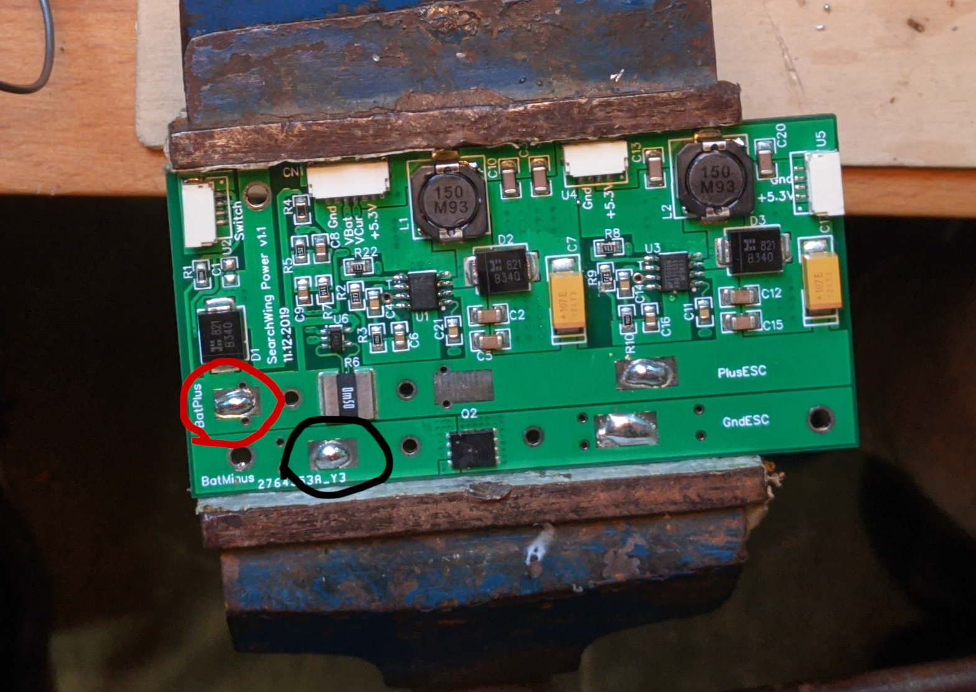
[picture p77: .gitbook/assets/powermodule_batterycable.jpg]
Red cable to &quot;BatPlus&quot; - Black cable to &quot;BatMinus&quot;


## Power Module -&gt; ESC

* Cut a 13cm piece of power cable \(red and black\) - long enough that the power module can be connected to the esc at the very end of the back part of THEBOX™ 
* Remove 3mm of isolation on both sides
* Presolder the wires
* Solder the both wires to the corresponding spots on the powermodule

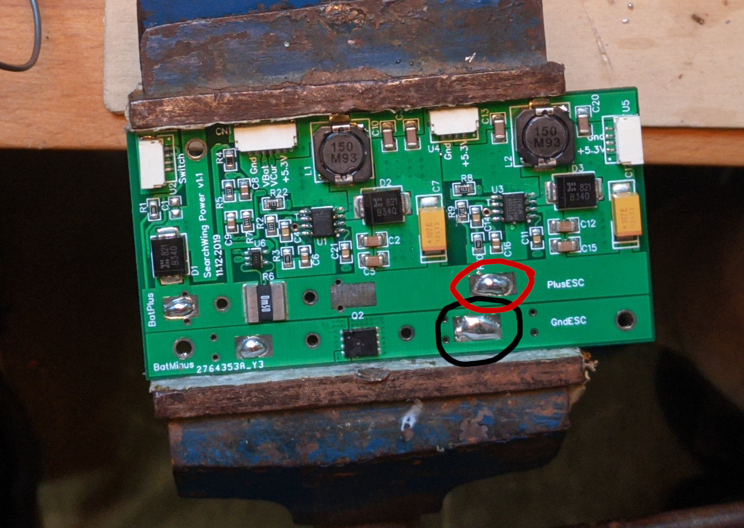
[picture p78: .gitbook/assets/powermodule_esccable.jpg]
Red cable to &quot;PlusESC&quot; - Black cable to &quot;GndESC&quot;


* Add two insolution tubes over the open ends of the cable
* Solder the two esc cables to the open ends of the cables from the step before

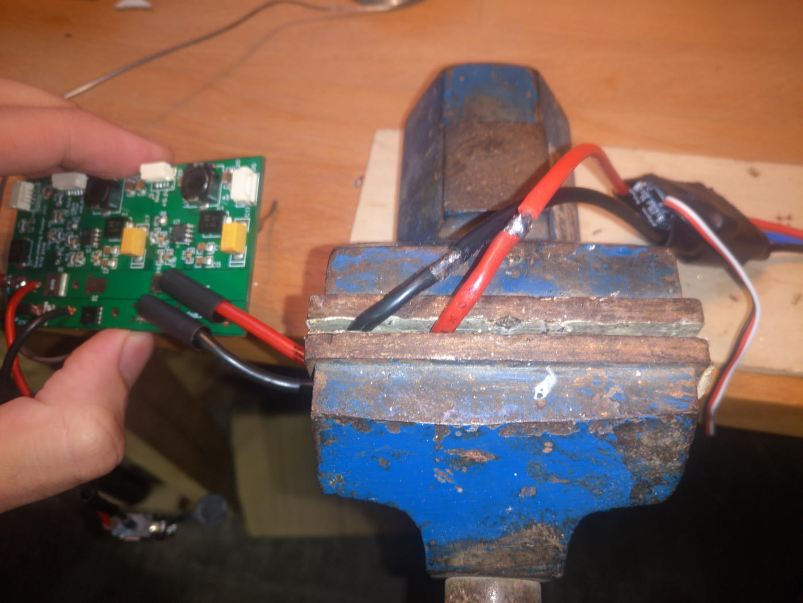
[picture p79: .gitbook/assets/powerboard_esc_insulation-tubes.jpg]
Soldered cables with insulation tubes.


* Shrink the insulation tubes over the open soldering spots using the heatgun

## External power plug -&gt; Power Module

* Add the prepared power plug to the powermodule like seen in the image below

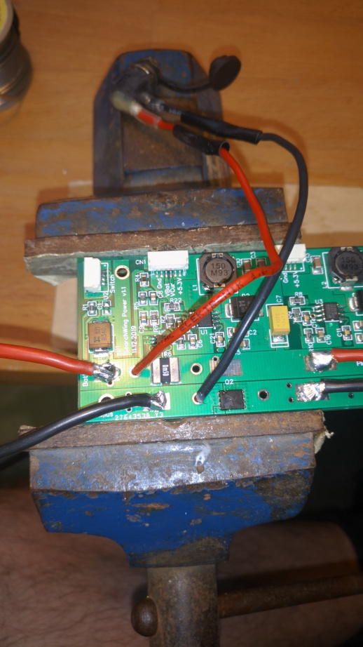
[picture p80: .gitbook/assets/external_power_power_module.jpg]
Insert the two cables like this


* Solder the cables at the back of the power module
  * Add some more solder to the soldering spot to get them soldered perfectly to the board
* Check you solderings by pulling and rotating them
  * No part of the cable should get free

Now your power module should look like this...

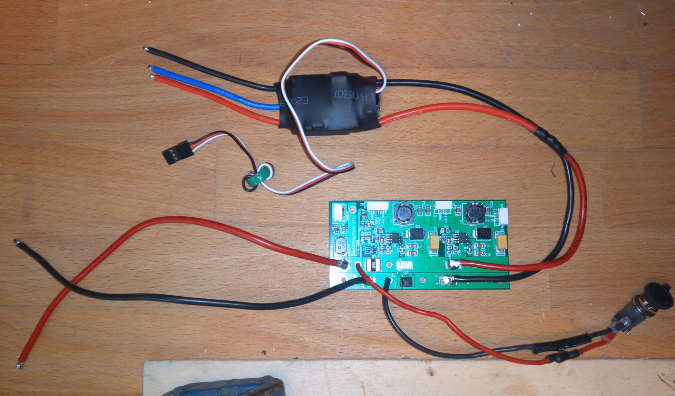
[picture p81: .gitbook/assets/powerboard_withcables (1).jpg]
Prepared powermodule with all internal cables soldered


## ESC -&gt; Motor

* Cut 3x 25cm pieces of power cable \(red + 2x black\) - long enough, that the motor and its pigtals could be later replaced without taking the fuselage apart

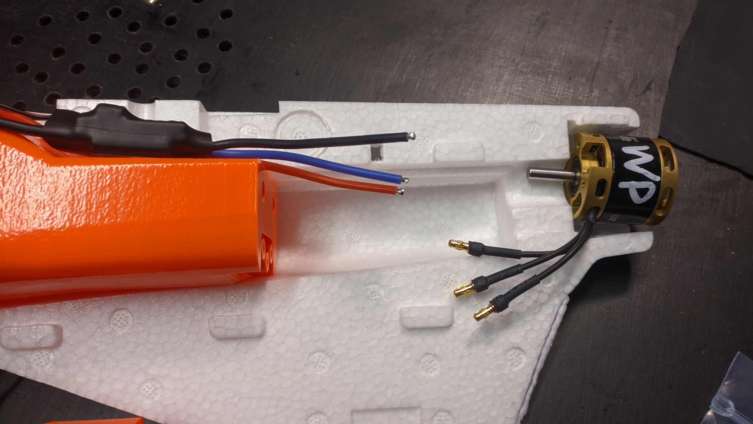
[picture p82: .gitbook/assets/img_20210712_172201.jpg]
The 3 cables should be long enough, that the connectors can be unplugged outside of the plane


* Remove 3mm of isolation on both sides
* Presolder the wires on both sides

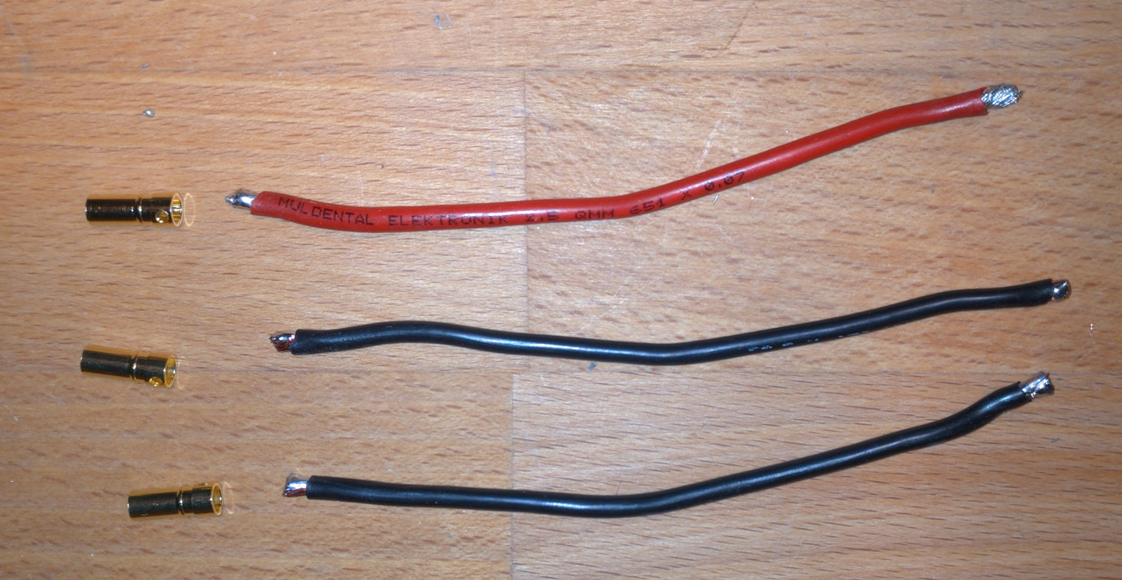
[picture p83: .gitbook/assets/presoldered_esc_cables.jpg]
Cables with its pigtails


* Presolder the motor pigtails 
  * with enough solder that the whole pigtail is covered with a bit of solder
  * a lot of heat from the soldering iron is needed for this the heat up the whole pigtail

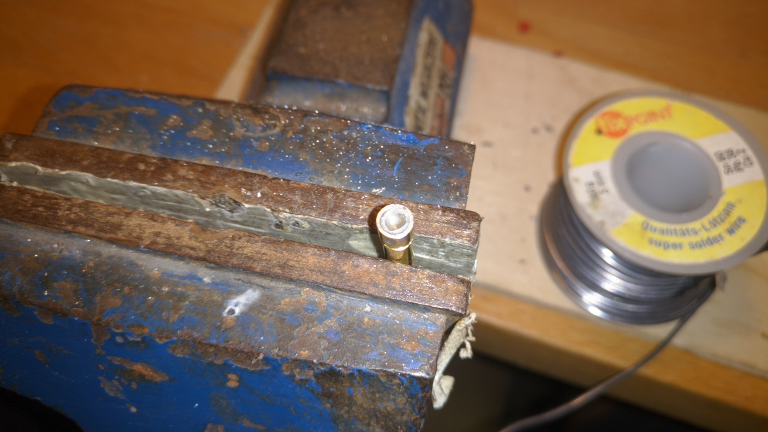
[picture p84: .gitbook/assets/presoldered_esc_pigtailes.jpg]
Presoldered pigtail


* Solder the presoldered pigtail with the presoldered cable

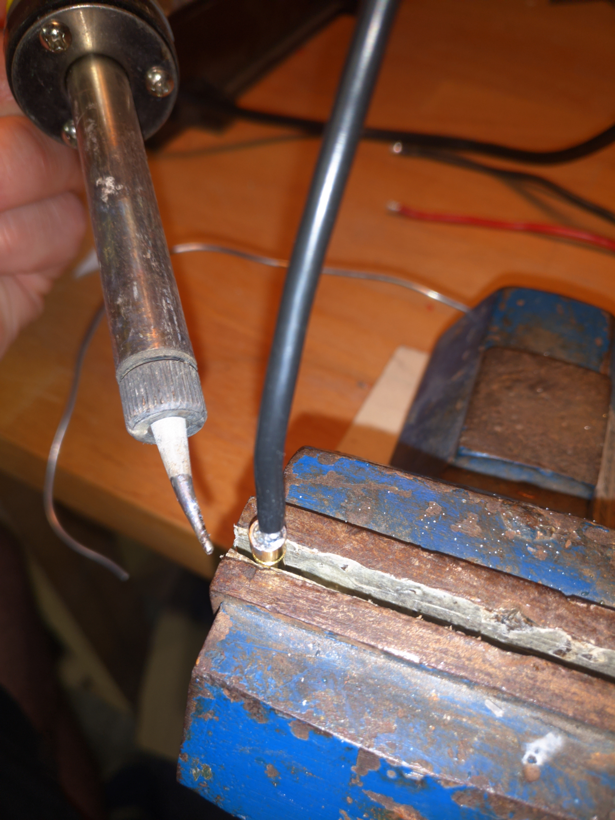
[picture p85: .gitbook/assets/soldered_esc_cables.jpg]


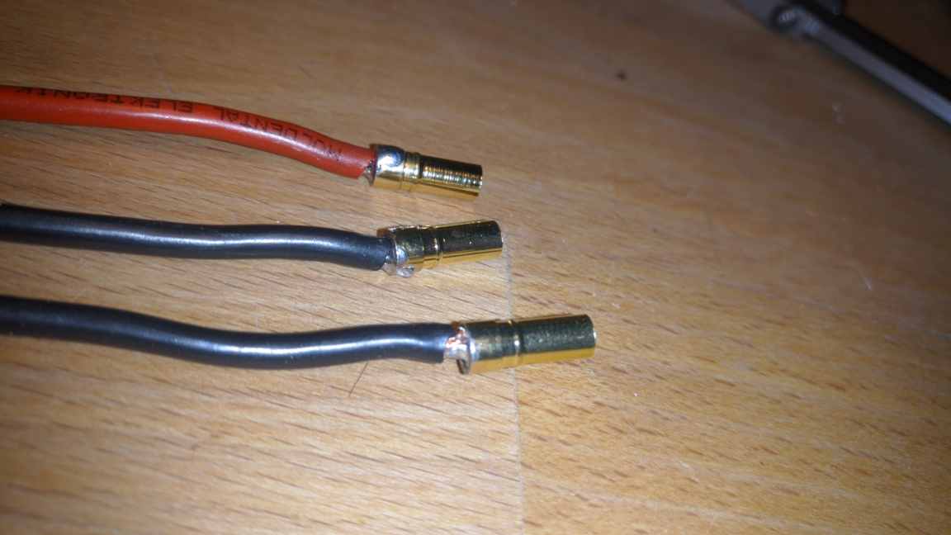
[picture p86: .gitbook/assets/soldered_esc_cables2.jpg]


## Shrinking the cables to the box

* TODO how to make waterproof
  * battery cables
  * ESC cables
    * to the box
    * to the motorconnectors
    * Which cables to put together to make the motor rotatet the correct direction?

## Finalization & Testing

* [ ] check this
* [ ] and that...
* [ ]
