KingBBQ/searchwingDronebuldingDoc/preparing-components/generic-componets/m5-servo-plugs.md

---
description: >-
  To connect the servos for ruders to the box, containing all the electronics,
  we use M5 connectors. These offer a small footprint and the required
  watertightness
---

# M5-Servo-Plugs

## Final Product

* 2x F1
* 2x F2
* 4x F3

All servo cable assemblies for one plane

## Requirements 

### Time required

* **Complete cable assebly set:** **170 min**
  * Preparation: 30 min
  * Building F1: 60 min
  * Building F2: 40 min
  * Building F3: 40 min

### Tools required



### Parts required

* [Prepared Servos](untitled-1.md) 
* 4x 
* 4x 



### Preparation

Schrumpfschlauch und Kabel ablängen 



## Step by Step Guide

#### 

#### 

### F1





### F2



### F3



### 

## P**in assignment**

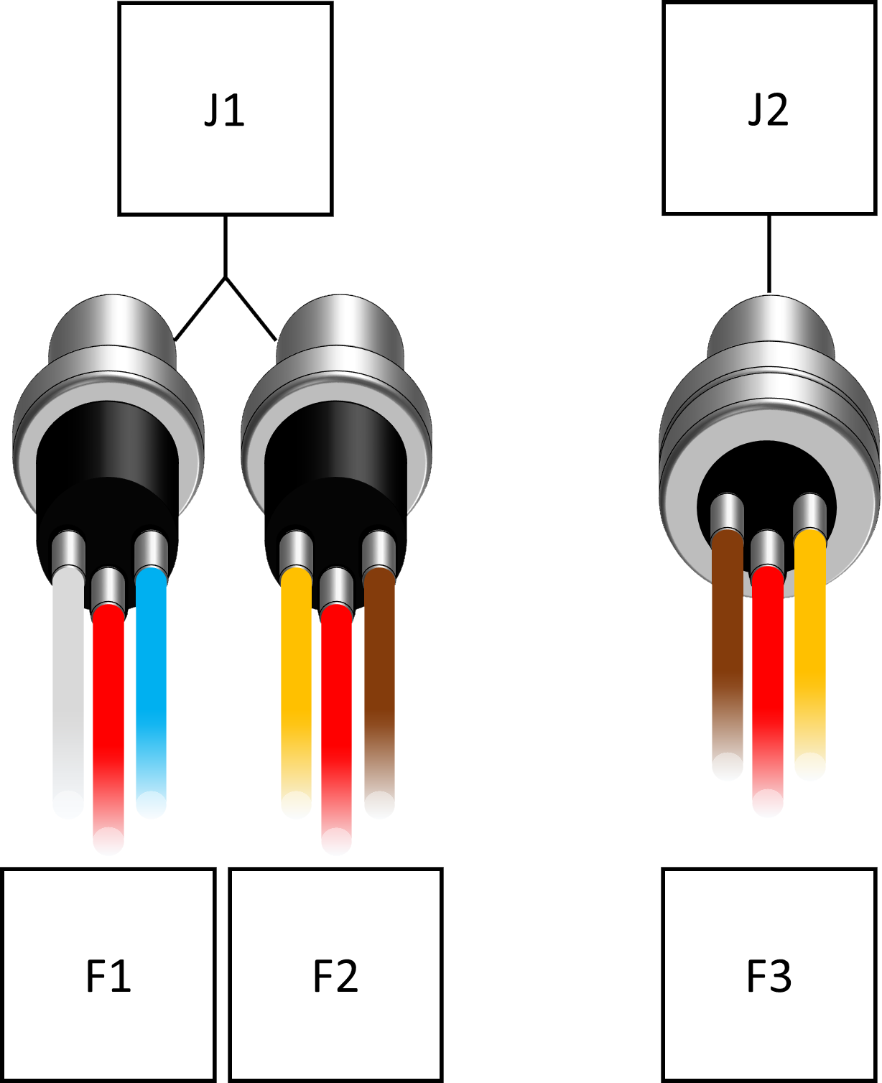
[picture p94: .gitbook/assets/servocable_pinbelegung2.png]


## **Tips and Tricks**

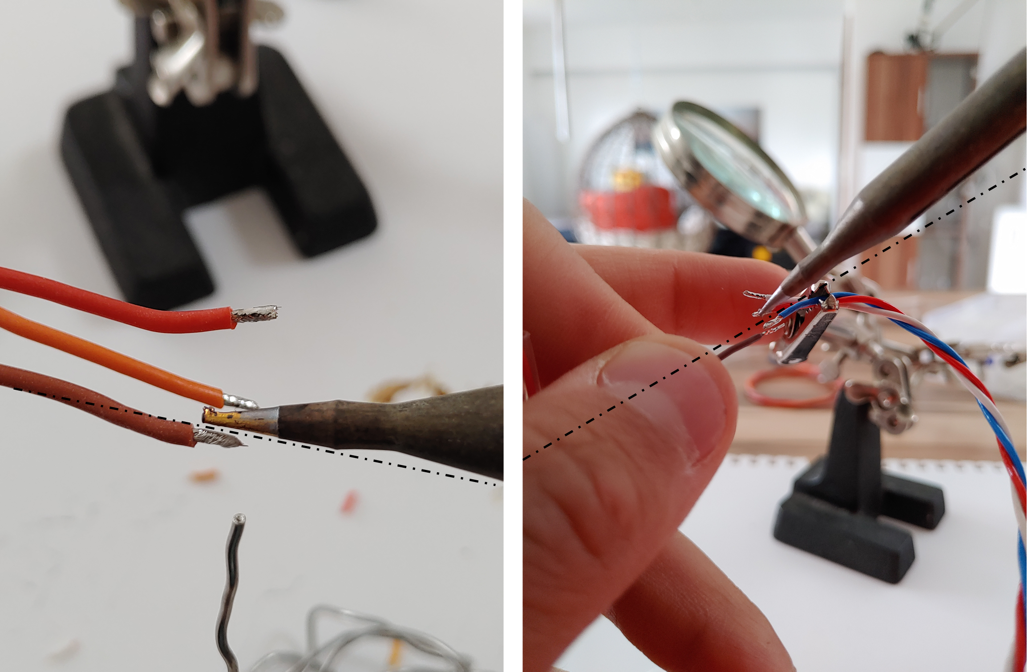
[picture p95: .gitbook/assets/servocable_parallelwire.png]


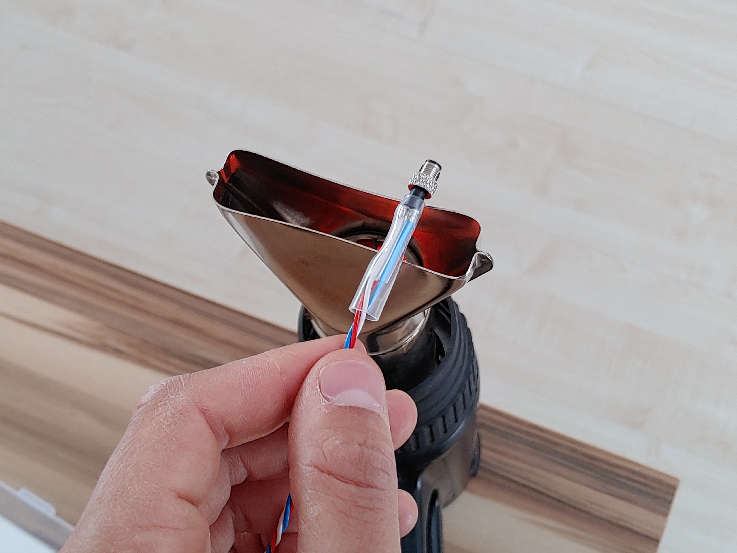
[picture p96: .gitbook/assets/servocable_heisluftfoen.jpg]


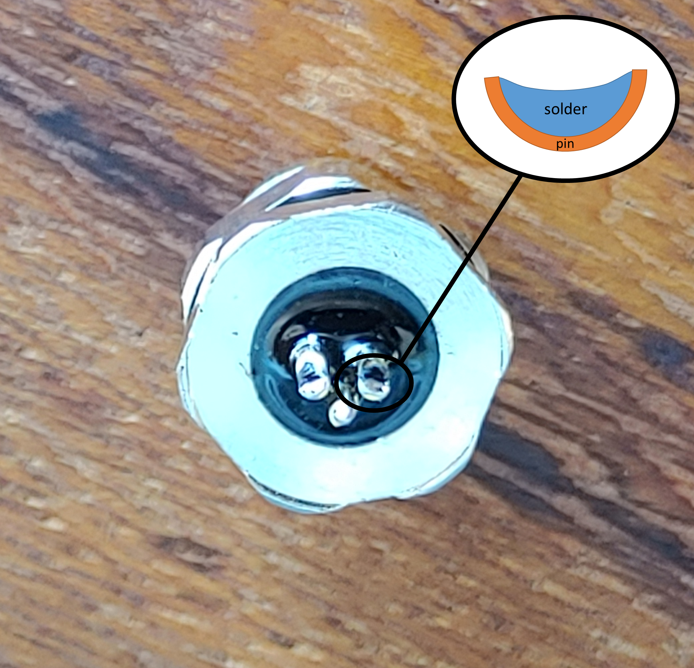
[picture p97: .gitbook/assets/servocable_solderpin.png]


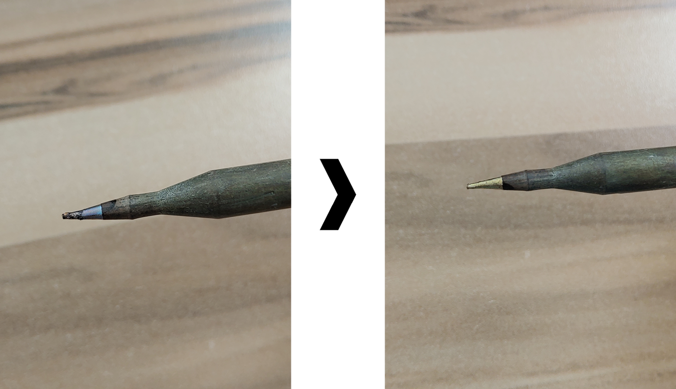
[picture p98: .gitbook/assets/servocable_soldertip.png]




## Finalization & Testing

* [ ] check this
* [ ] and that...

#### Outdated Manual: 

{% embed url="https://www.hs-augsburg.de/homes/beckmanf/dokuwiki/doku.php?id=searchwing-wing-servo&s\[\]=m5" %}
