KingBBQ/searchwingDronebuldingDoc/preparing-components/generic-componets/untitled-1.md

# Waterproofing the servos

#### Time required

* **Building:** 30 minutes
* **Curing**: 1 day

#### Tools required

* 
#### Parts required

* Servos
* O-Ring
* Silikon

## Finalization & Testing

* [ ] check this
* [ ] and that...
