KingBBQ/searchwingDronebuldingDoc/parts/list-of-parts-and-where-to-buy.md

# List of Parts and where to buy

## Remote Control

### Receiver

{% embed url="https://www.mhm-modellbau.de/part-FrSky-RXSR.php" %}
