KingBBQ/searchwingDronebuldingDoc/template-for-instructions.md

---
description: This page can be used as a template for individual instruction pages.
---

# Template for instructions

#### Time required

* **Building:** 30 minutes
* **Curing**: 2 days

#### Tools required

* 
#### Parts required

* Extron Motor
* Bearing
* Bearing

## Step 1: 

{% hint style="info" %}
Give special instrucktion... 
{% endhint %}

## Step 2:

## Finalization & Testing

* [ ] check this
* [ ] and that...
