KingBBQ/searchwingDronebuldingDoc/preparing-components/combining-components/building-v-tails-and-wings.md

# Building V-Tails and Wings

#### Time required

* **Building:** 30 minutes

#### Tools required

* UHU Por glue
* spatula
* silicone
* \(1.2mm drill\)

#### Parts required

* Extron Motor plus screws etc.
* 3D printed motor mount
* Servos with assembled servo arm
* servo push rods
* \(optional: flexible tube\)

## Preparing the wings

### Preparing and installing the servo pushrods

You can choose between two methods to mount the servo rods to the servo horns. If you don't want to drill a hole in the rudder horn, you can also use a flexible tube with and circumference of 2mm.

{% tabs %}
{% tab title="Tube Method" %}
For the long two Pushrods cut off 150mm long wires, and 15mm long tube pieces and put the tube on one end like this:

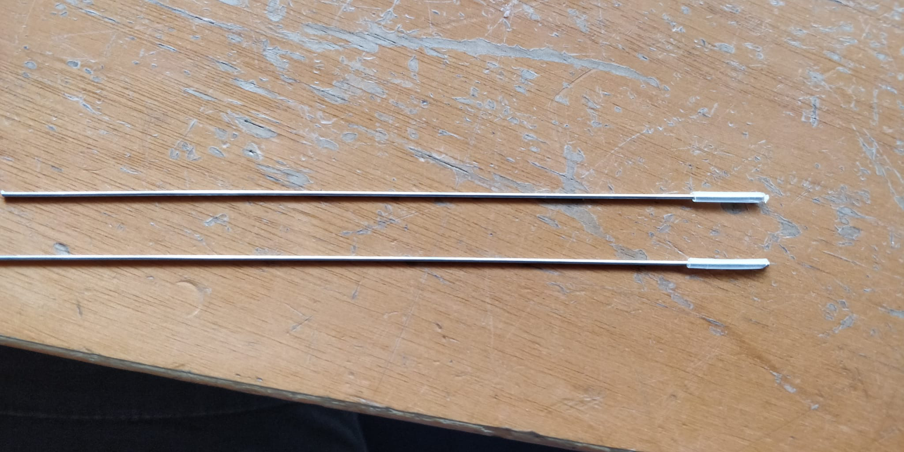
[picture p108: .gitbook/assets/wires_with_tubes_not_bended.jpeg]


Now bend the wires with the tube:

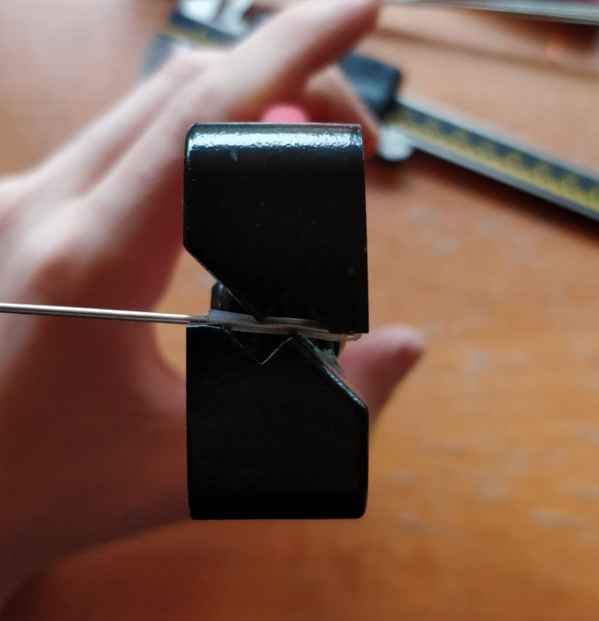
[picture p109: .gitbook/assets/bending_the_wires.jpeg]


Now the other side like this:



**Repeat the process with two 75mm long wires**.
{% endtab %}

{% tab title="Drilling Method" %}

Main Wing Puhsrods - 130mm

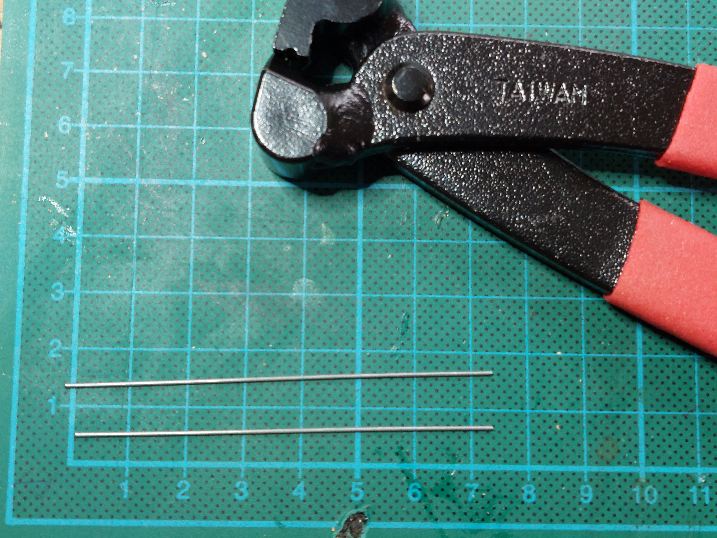
[picture p111: .gitbook/assets/servo-pushrods-1-tail.jpg]
Puhsrods for the V-Tails - 75mm




Drill 1mm holes into the rudder horns
{% endtab %}
{% endtabs %}

### Install the carbon

#### V-Tails

Put glue on the carbon rod and the corresponding place in the vtail. Wait 10 minutes and push the rod into the corresponding place.

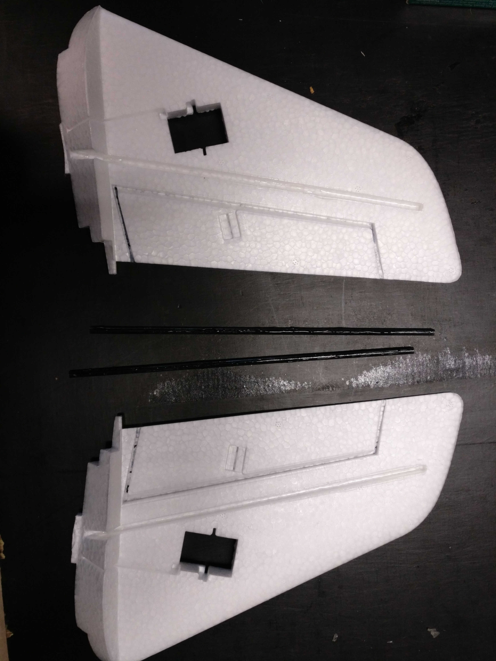
[picture p112: .gitbook/assets/vtail_carbon_rod.jpg]


#### Wings

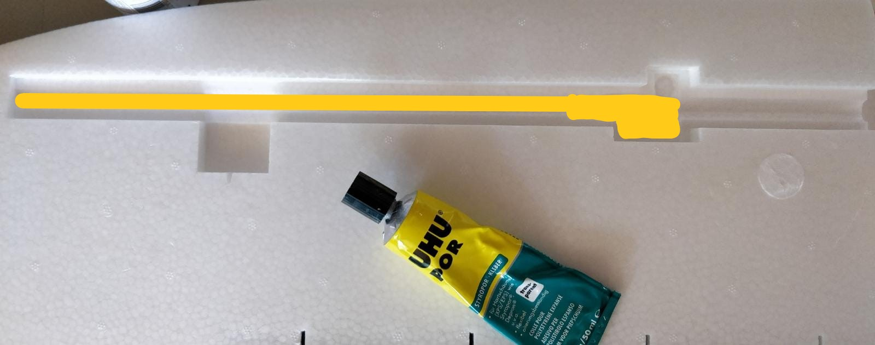
[picture p113: .gitbook/assets/whatsapp-image-2021-08-11-at-11.57.52.jpeg]
Apply UHU-POR to the surface marked yellow in the picture.


Put the carbon wing pipe into the glue and remove it again so that the glue gets to the contact dry. Wait about 10 minutes.

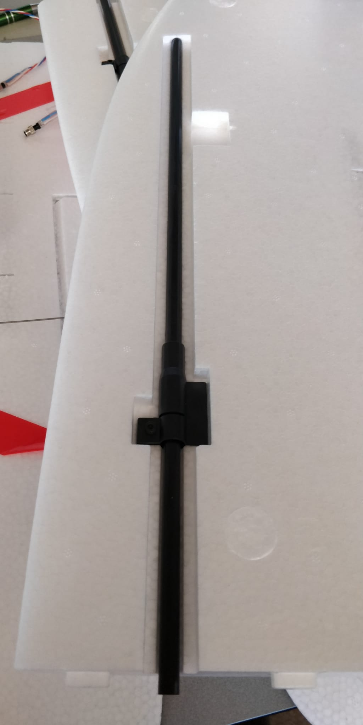
[picture p114: .gitbook/assets/wing_carbon_pipe_glued.jpeg]


When putting back the carbon parts apply high force to get a better stabillity. 

### Installing the rudder horn

Put glue on the lower part of the ruder horn. Put glue on the wing part.

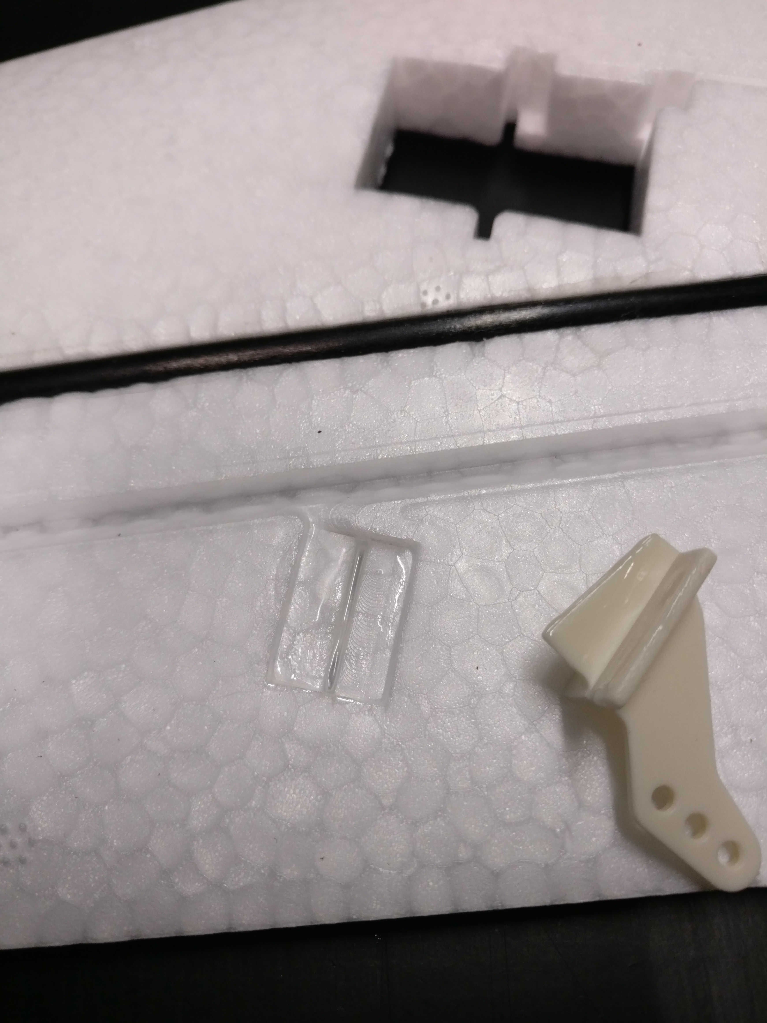
[picture p115: .gitbook/assets/ruderhorn_with_glue.jpg]
ruder horn with glue


Insert the ruder horn into the wing and apply pressure:

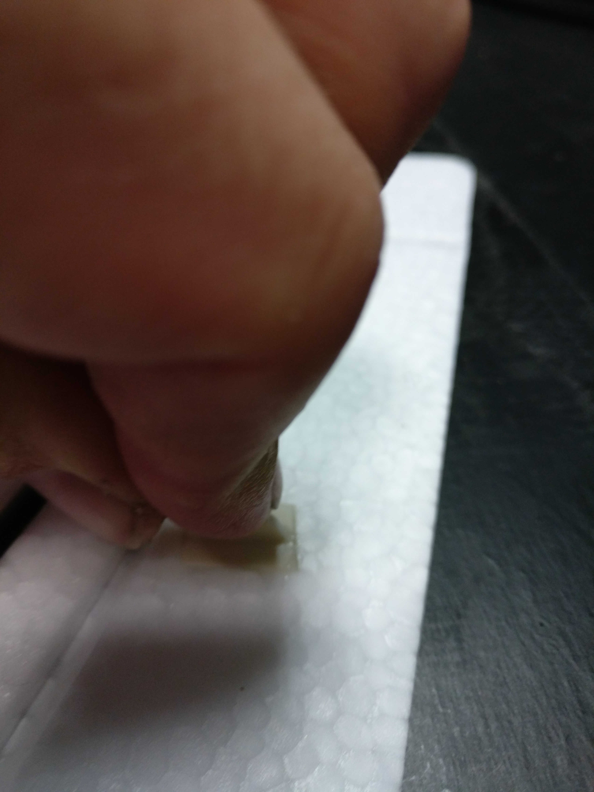
[picture p116: .gitbook/assets/ruderhorn_under_pressure.jpg]
ruderhorn under pressure


Ruder horn after proper assembly:

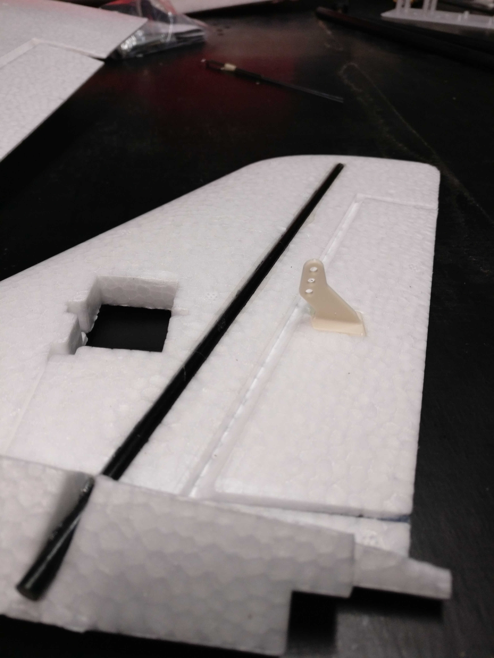
[picture p117: .gitbook/assets/ruderhorn_glued.jpg]


Now cut free the rudder of the V-Tail:

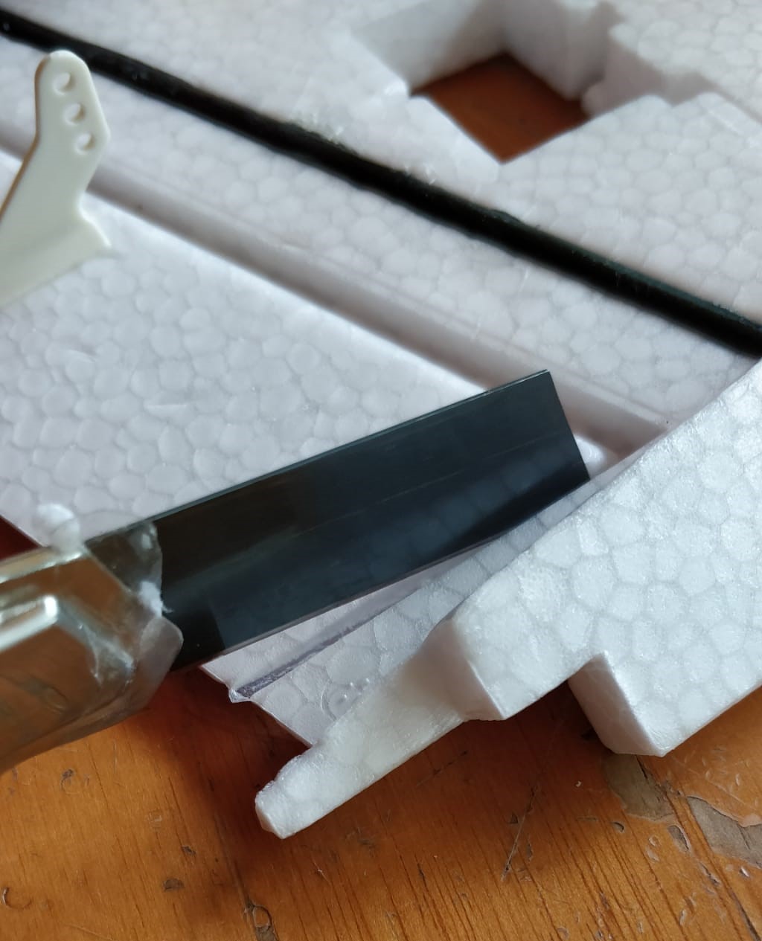
[picture p118: .gitbook/assets/cutting_vtail (1).jpeg]


**Repeat the process with the Wings.**

### Installing the servos into the wings

Make sure the servo is centered before installing the servo into the wing. Make sure the servo arm is installed with a O-Ring inbetween the servo arm and the servo housing.

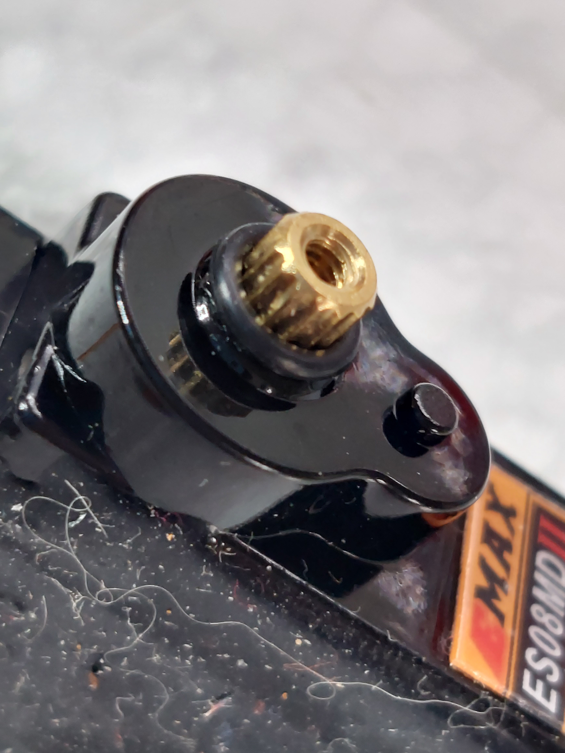
[picture p119: .gitbook/assets/wings-prepare-servo-2 (1).jpg]
Add the O-Ring and some grease or oil


Center all the servos \(neutral position\)

#### Installing the servos in the main wings

Before continuing with glueing the servos and cable into the wing make sure the carbon tubes are inserted into the wings.

**There is a right and wrong way:**

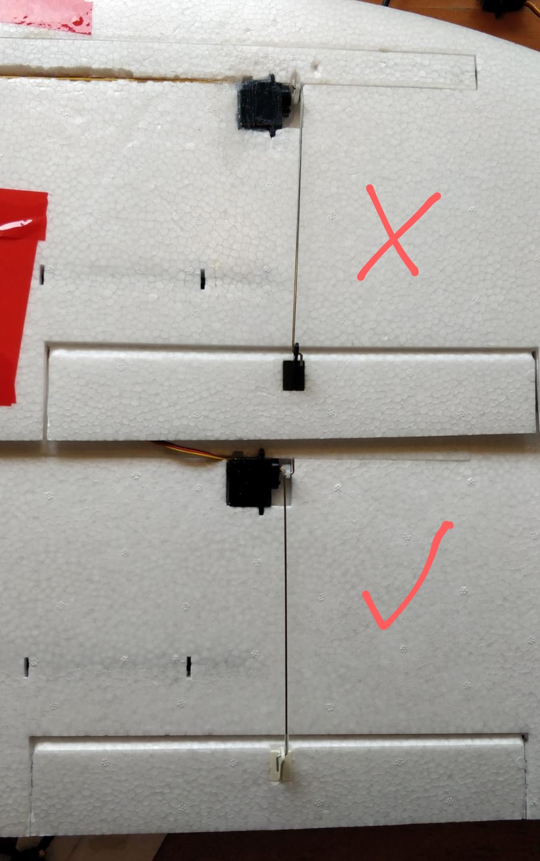
[picture p120: .gitbook/assets/wires_right_wrong.jpeg]


**The short wire part after the angled part at the rudder horn is on the plane inside.**

Center the ailerons - then attach the rudder horn on the servo


Only then attach and tighten the screw


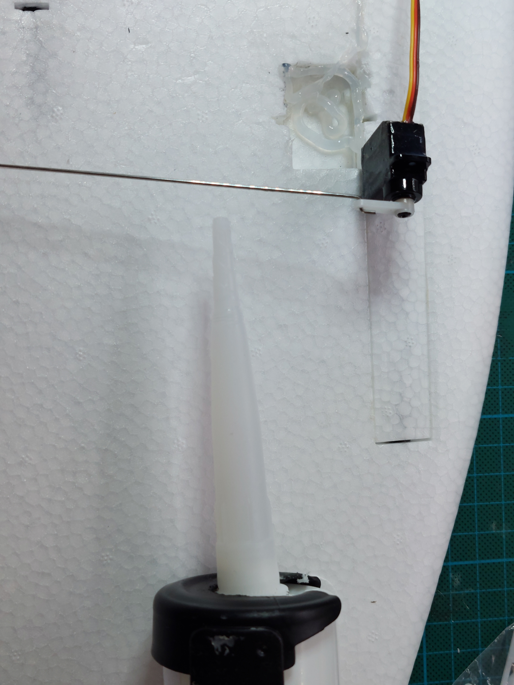
[picture p123: .gitbook/assets/wing-main-3.jpg]


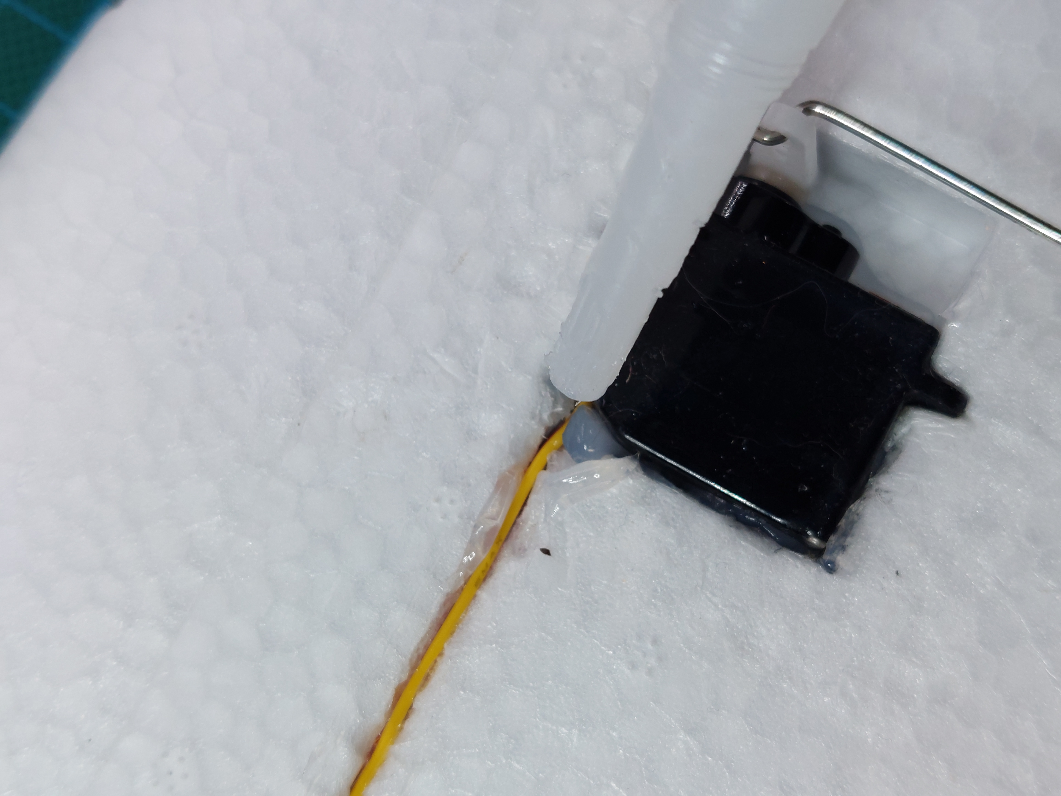
[picture p124: .gitbook/assets/wing-main-4.jpg]
Add silicon at the cable connection to the servo - this part can be problematic otherwise


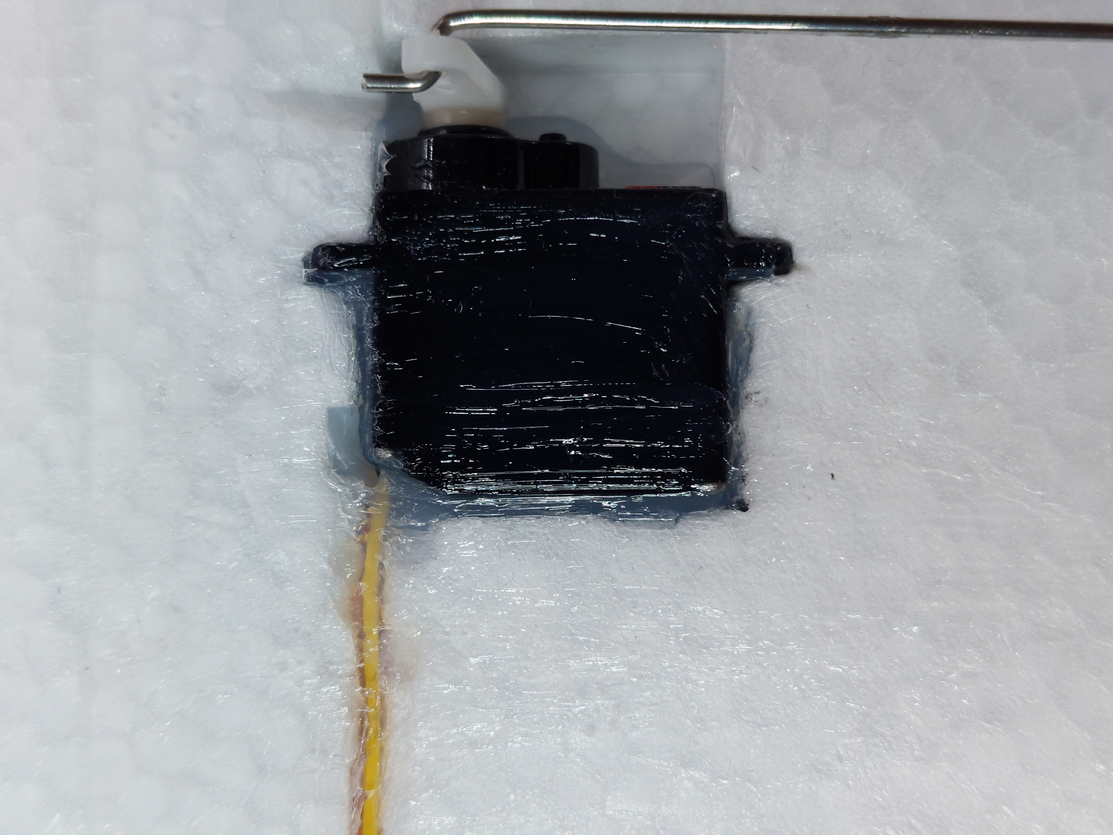
[picture p125: .gitbook/assets/wing-main-5.jpg]
Finished Servo


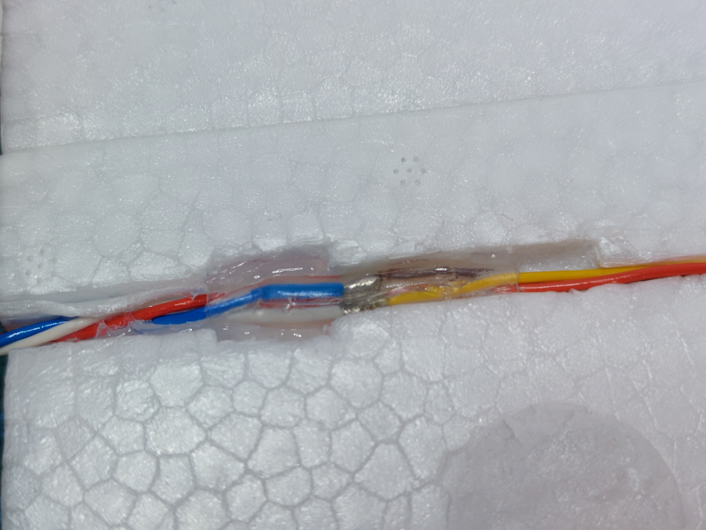
[picture p126: .gitbook/assets/wing-main-6.jpg]
Also fix the cables with silicon


The cables on the wings/V-tails shoult look like this:

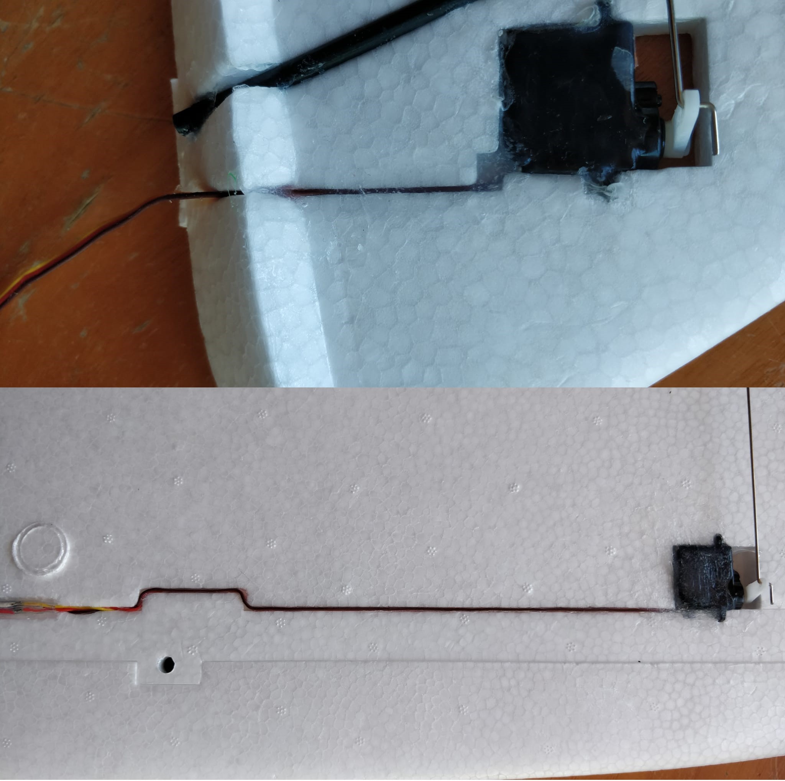
[picture p127: .gitbook/assets/cable_v_tail_wing.jpeg]


#### V-Tails

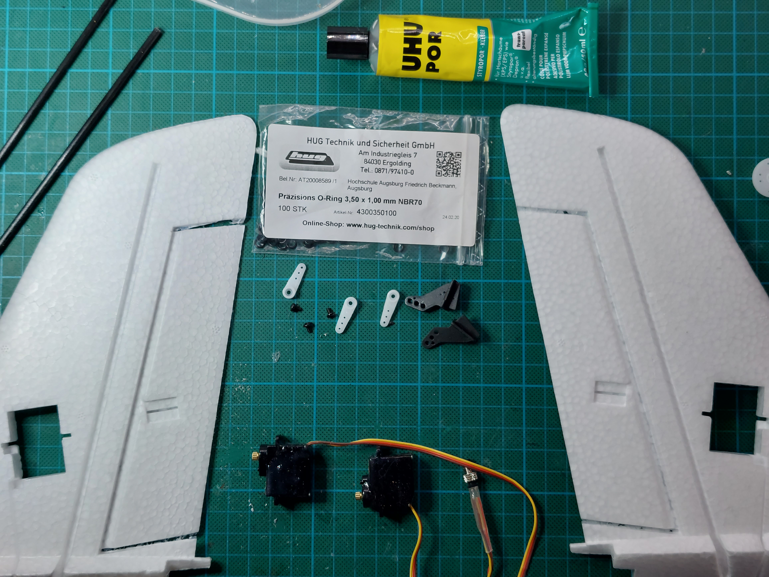
[picture p128: .gitbook/assets/wing-tail-1-.jpg]


Again - center the rudder and then put the rudder horn on the servo


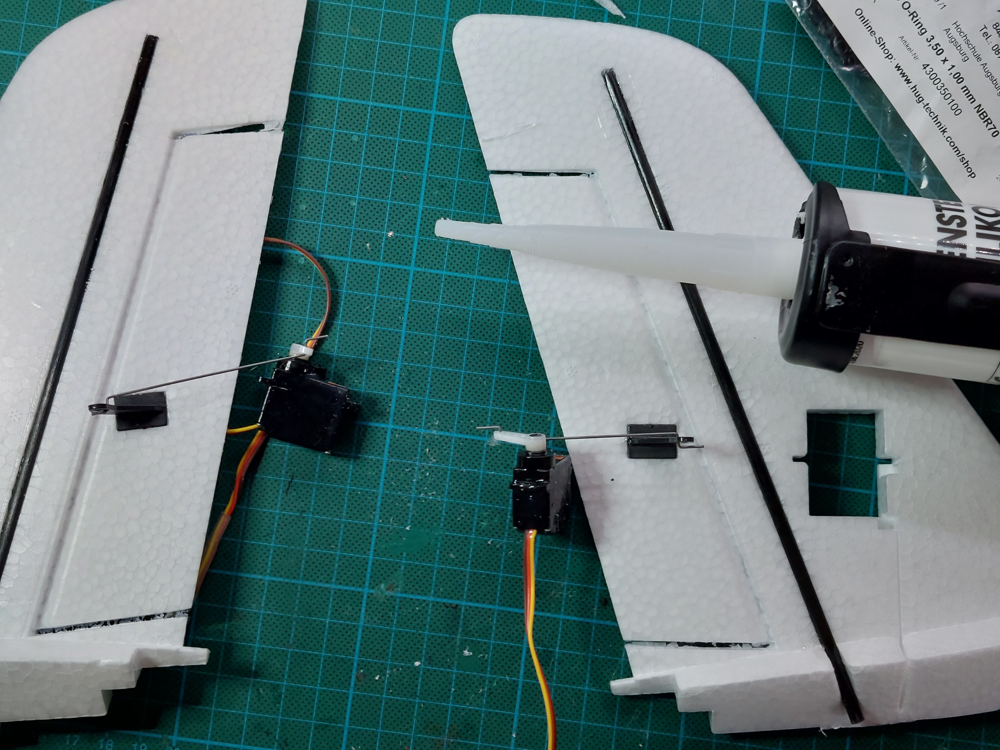
[picture p130: .gitbook/assets/wing-tail-5.jpg]


## Finalization & Testing

* [ ] are the carbon pipes glued in?
* [ ] do the servos work?
* [ ] are the cables and servos glued in?
* [ ]
