KingBBQ/searchwingDronebuldingDoc/preparing-components/generic-componets/motor-assembly-and-motor-mount-preparation.md

# Motor assembly and motor mount preparation

### Required

* Motor marked with "WP" \(waterproof\)
* 4 screws M3x6mm
* 4 screws cylindric head
* 4 non-metric? screw for motor mount
* 4 screw nuts
* motor cross
* 3D-printed motor mount
* **Loctite for all screws!**

### Motor cross and propeller axis

* Screw motor cross to motor \(M3x6mm, PH1, metric with countersunk head\)

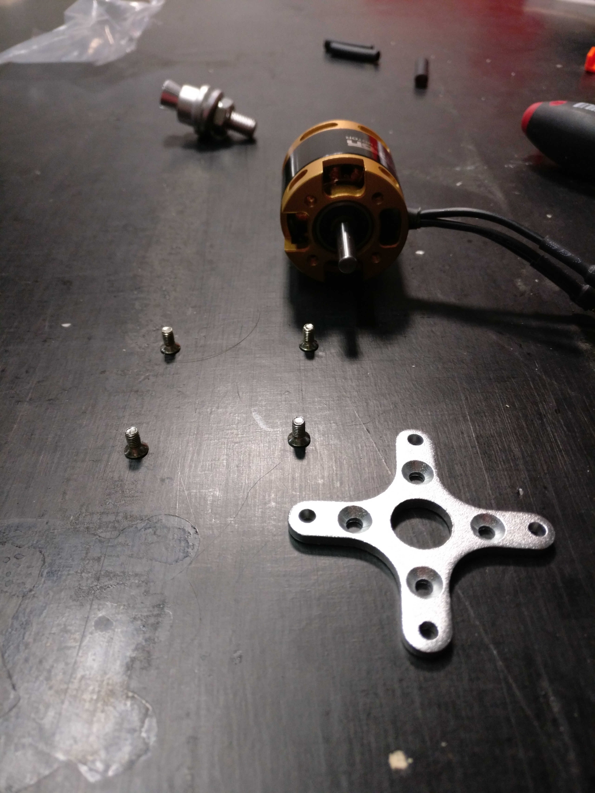
[picture p139: .gitbook/assets/motor_crossmount_prior_to_assembly.jpg]


* screw propeller axis to motor

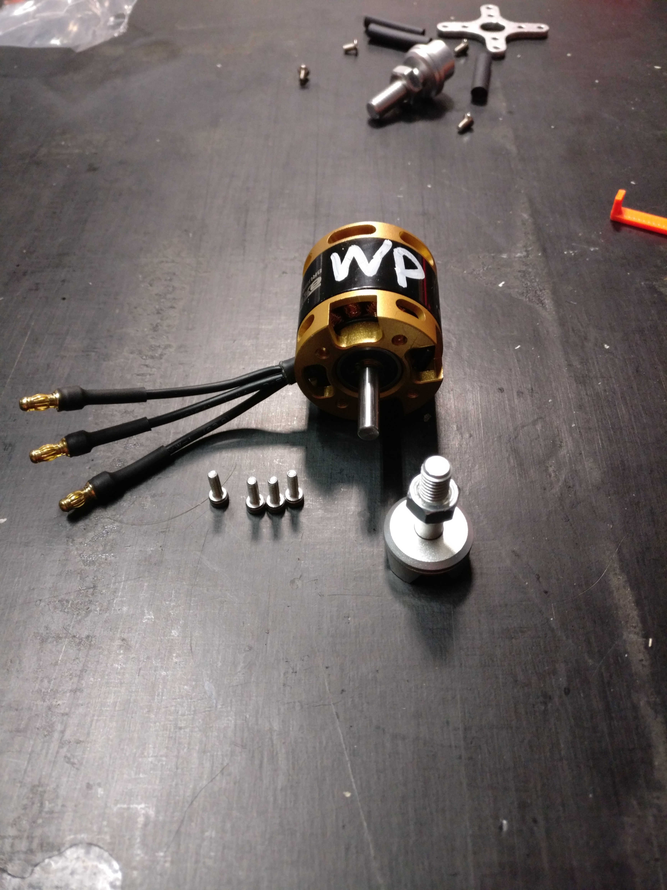
[picture p140: .gitbook/assets/motor_axel_prior_to_assembly.jpg]


### Motor mount

* Press nuts in motor mount \(heat nuts and use tool\)

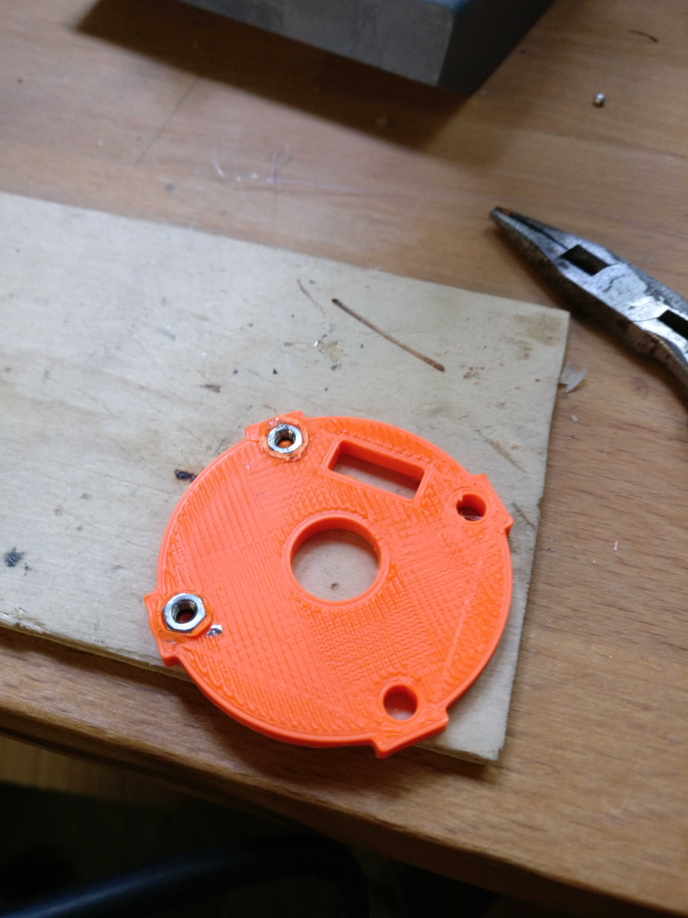
[picture p141: .gitbook/assets/motormount_nuts_inserted.jpg]


* screw motor cross to motor mount \(M3x10mm, PZ1, not metric?\)

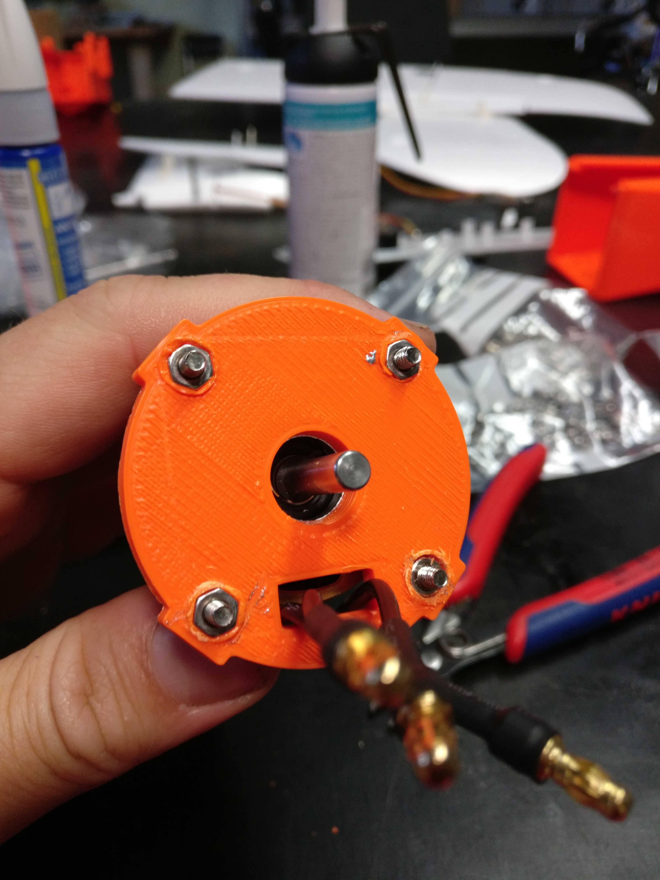
[picture p142: .gitbook/assets/motor_mounted_to_motormount.jpg]
