KingBBQ/searchwingDronebuldingDoc/testing-and-development/how-to-create-watertight-3d-prints/detect-thin-walls-setting.md

# Detect thin walls setting

We discovered strange tiny holes on the initial prints. We found these holes also in the slicer preview:

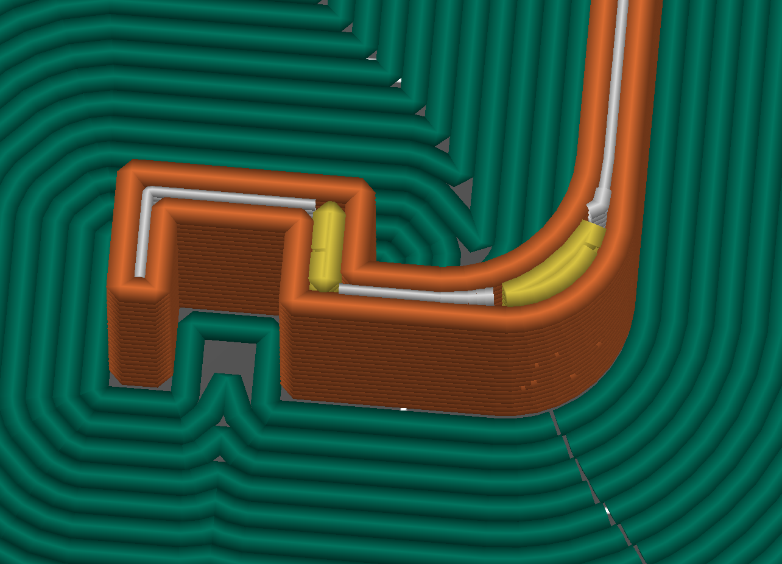
[picture p158: .gitbook/assets/prusaslicer-setting-detect-thin-walls-deactivated.png]
Holes inside the wall of the box


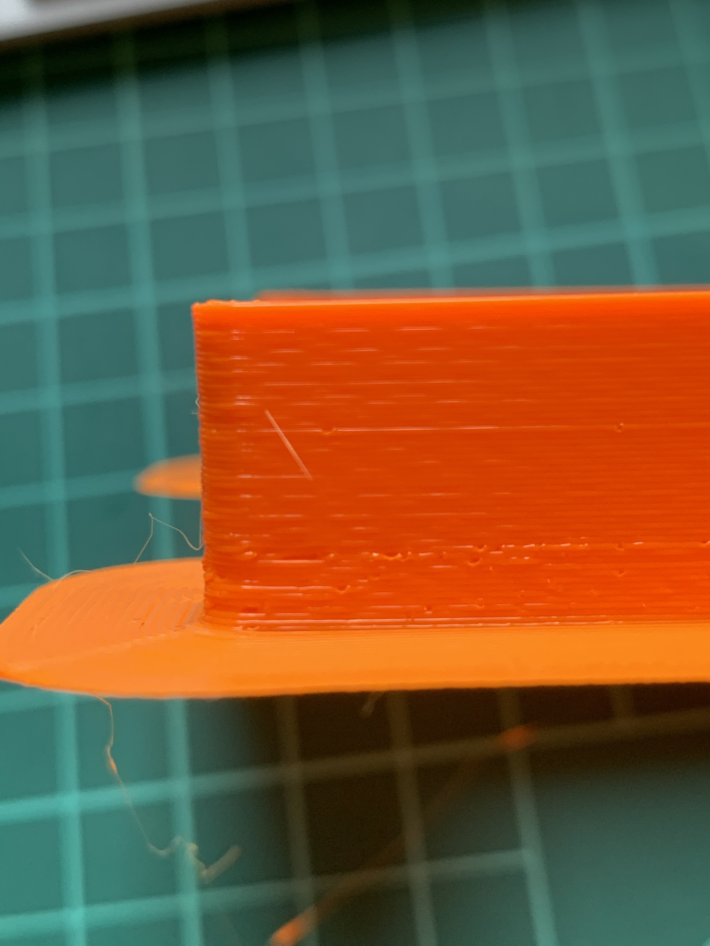
[picture p159: .gitbook/assets/prusaslicer-setting-detect-thin-walls-deactivated-test-print.jpg]


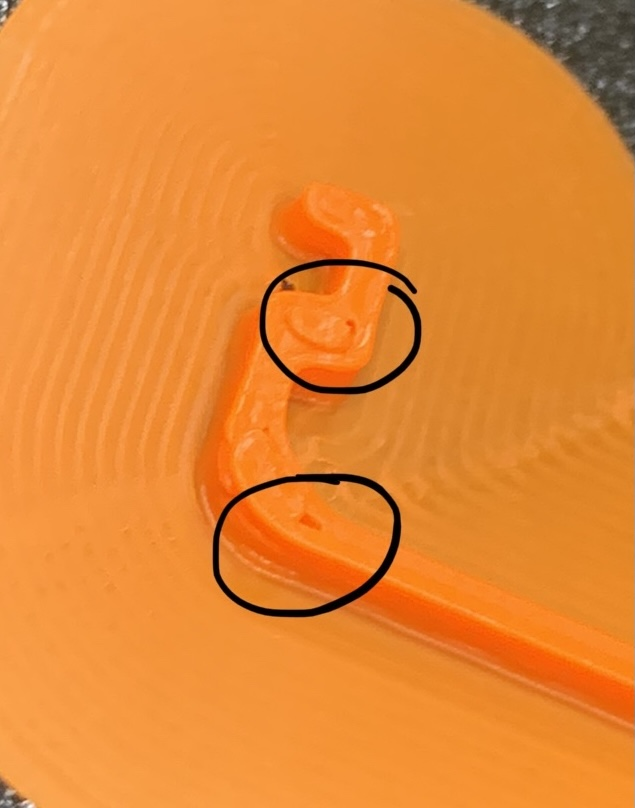
[picture p160: .gitbook/assets/prusaslicer-setting-detect-thin-walls-deactivated-test-print-internal.jpg]


## Change the setting 

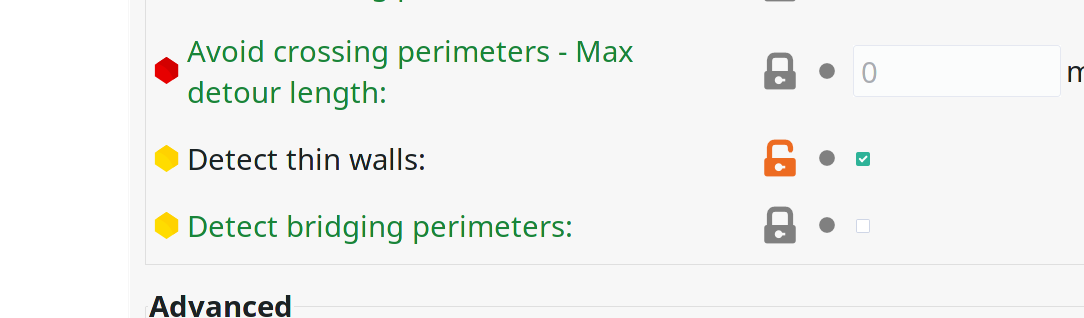
[picture p161: .gitbook/assets/prusaslicer-setting-detect-thin-walls.png]


### Result in the slicer

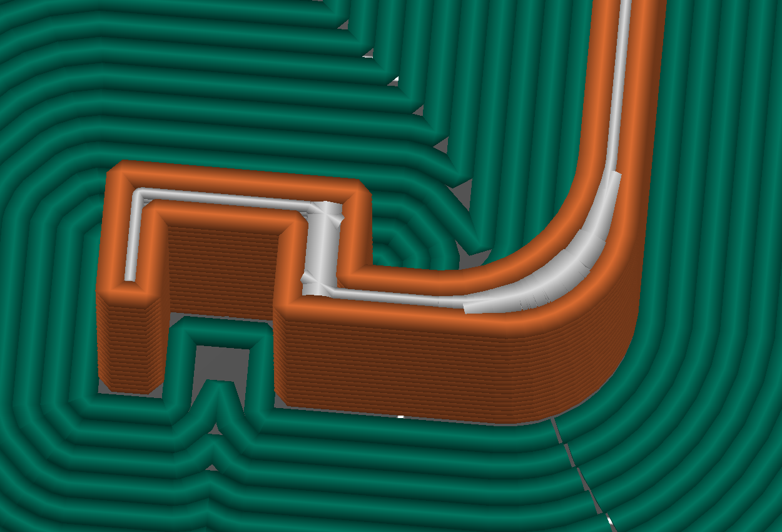
[picture p162: .gitbook/assets/prusaslicer-setting-detect-thin-walls-activated.png]


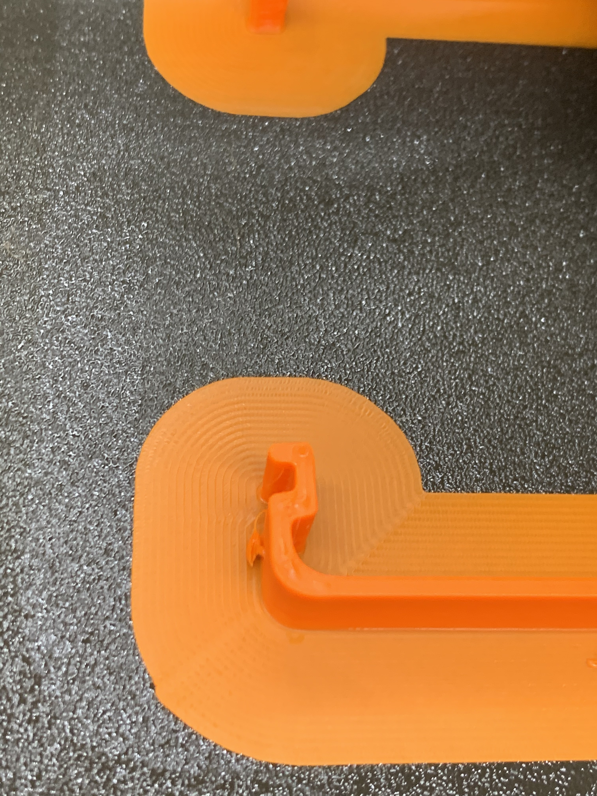
[picture p163: .gitbook/assets/prusaslicer-setting-detect-thin-walls-activated-test-print-internal.jpg]


Also the outer walls are much nicer now:

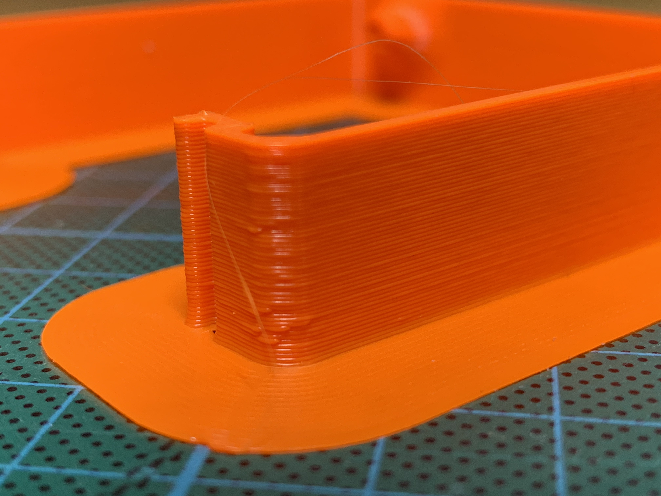
[picture p164: .gitbook/assets/prusaslicer-setting-detect-thin-walls-deactivated-test-print-outer.jpg]
&quot;Detect thin walls&quot; - deactivated


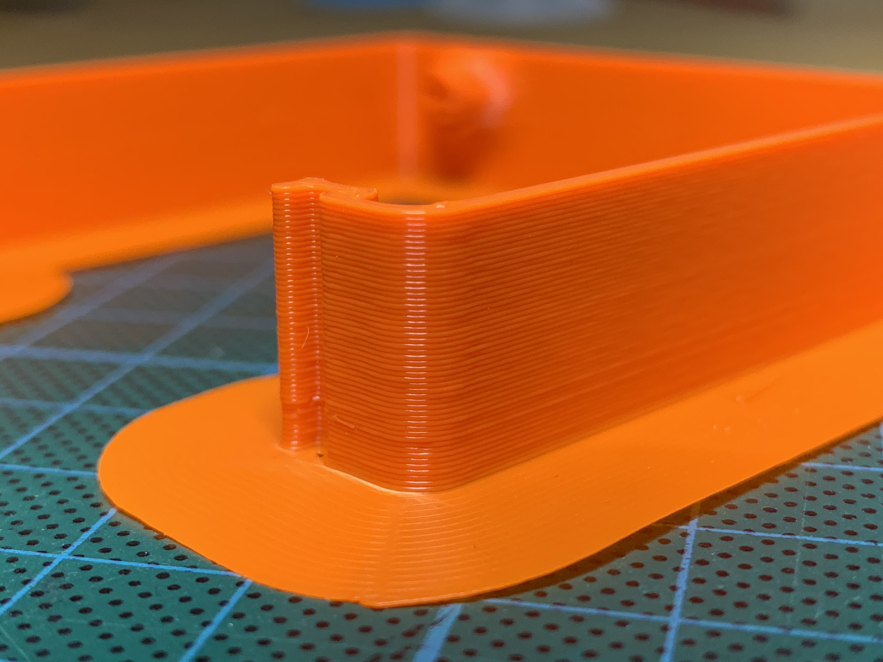
[picture p165: .gitbook/assets/prusaslicer-setting-detect-thin-walls-activated-test-print-external.jpg]
&quot;Detect thin walls&quot; - activated
