KingBBQ/searchwingDronebuldingDoc/testing-and-development/how-to-create-watertight-3d-prints/the-right-filament.md

# The right filament - and the richt settings.

We use ASA for printing the box:

* light
* good layer adhesion
* aceton smoothing

We use Extrudr Dura Pro Asa, which requires lower print temperatures than normal ASA:



If its too hot, the result looks a bit like Swiss cheese:

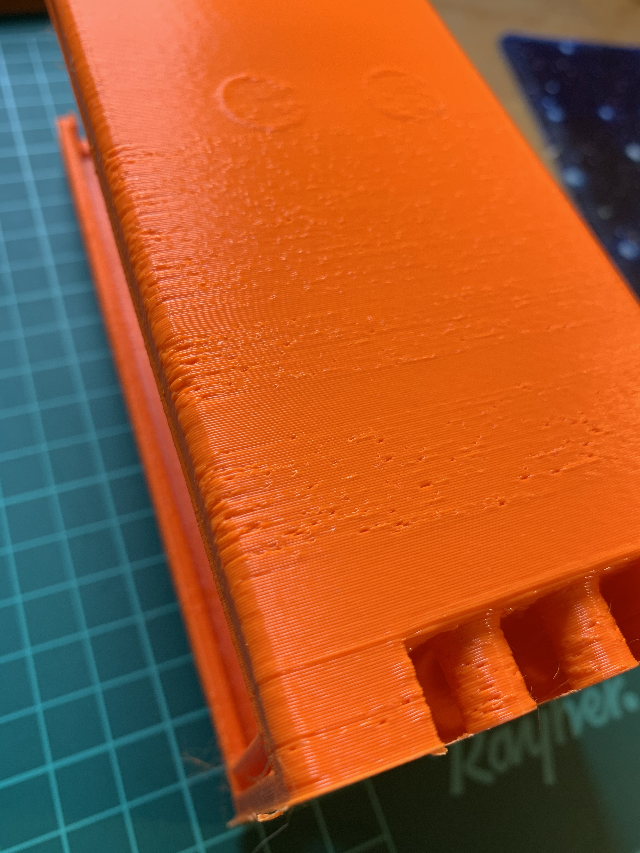
[picture p166: .gitbook/assets/3d-testprint-asa-extrudr-too-hot.jpg]
