KingBBQ/searchwingDronebuldingDoc/preparing-components/software-setup/setup-groundcontrol-laptop.md

# Setup Groundcontrol Laptop

## Load latest image to the laptop

* Download latest clonezilla image from [https://cloud.hs-augsburg.de/s/gPpRWP6r69FqyZp](https://cloud.hs-augsburg.de/s/gPpRWP6r69FqyZp)
* Install image to the laptop using this instructions [https://clonezilla.org/show-live-doc-content.php?topic=clonezilla-live/doc/02\_Restore\_disk\_image](https://clonezilla.org/show-live-doc-content.php?topic=clonezilla-live/doc/02_Restore_disk_image)

## How to use

* TODO
*
