KingBBQ/searchwingDronebuldingDoc/Photos/Assembly/Binding.jpg

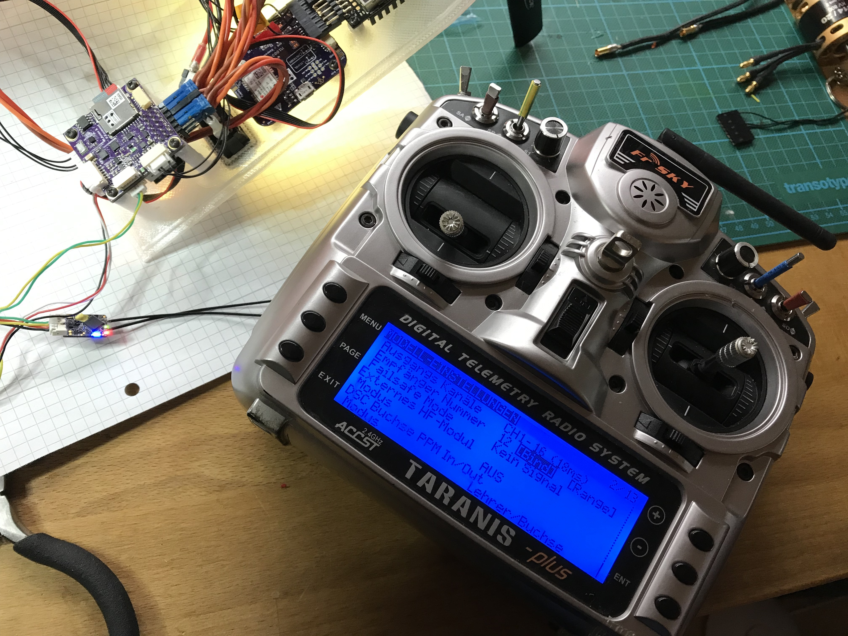
Photos/Assembly/Binding.jpg
