KingBBQ/searchwingDronebuldingDoc/Photos/Assembly/Pixracer Connections.jpg

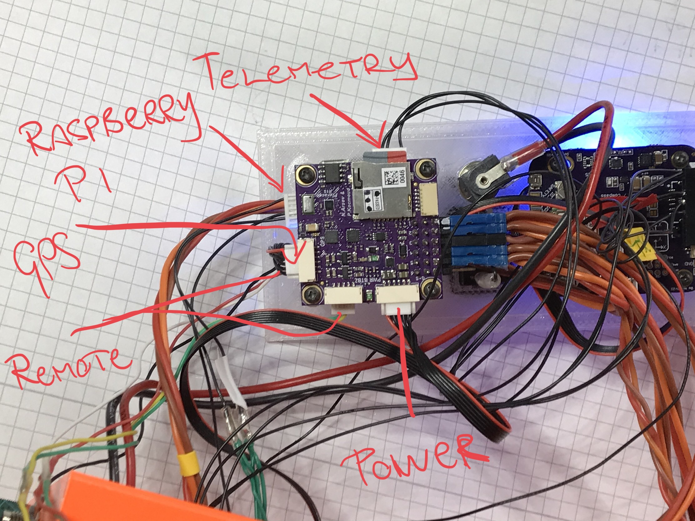
Photos/Assembly/Pixracer Connections.jpg
