KingBBQ/searchwingDronebuldingDoc/Photos/Assembly/Wing Tail 6.jpg

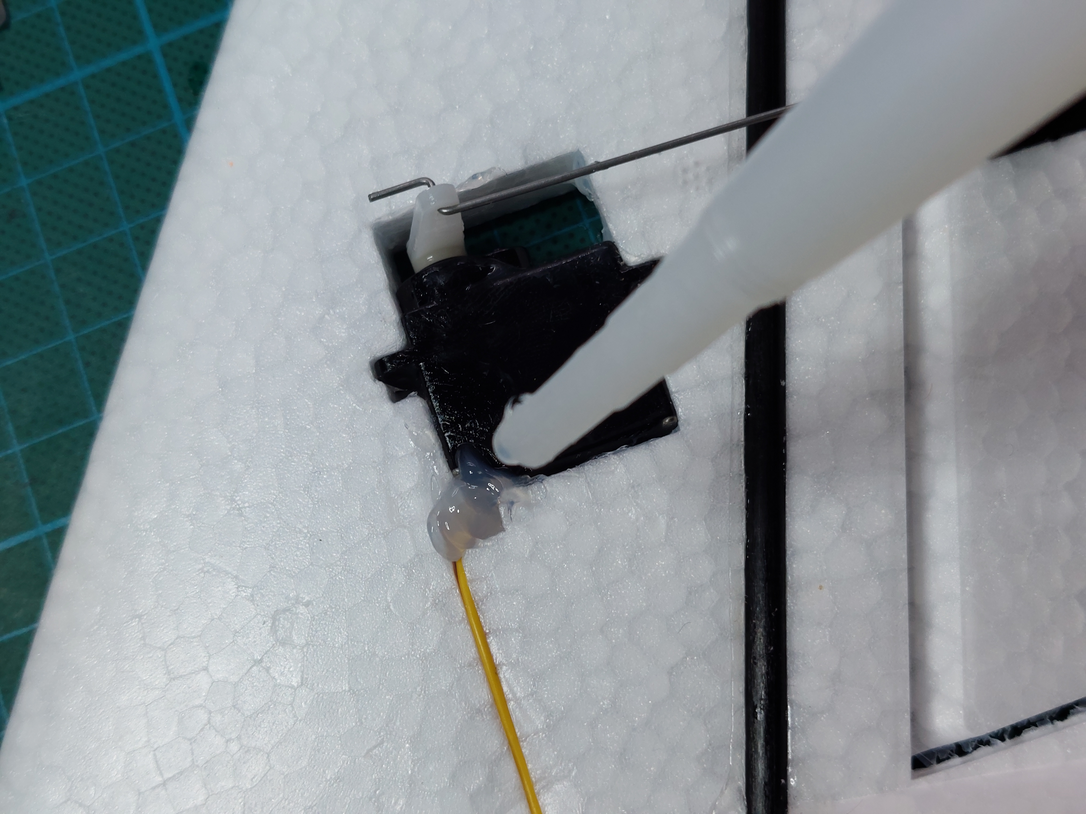
Photos/Assembly/Wing Tail 6.jpg
