KingBBQ/searchwingDronebuldingDoc/testing-and-development/watertight-cable-connections.md

# Watertight cable connections

## Silicon vs. PVC Cables

Shrinking the cables watertight requires a good adhesion between the cable and the shrink tube / hot glue. Tests showed that silikon cables are not as good as normal PVC cables

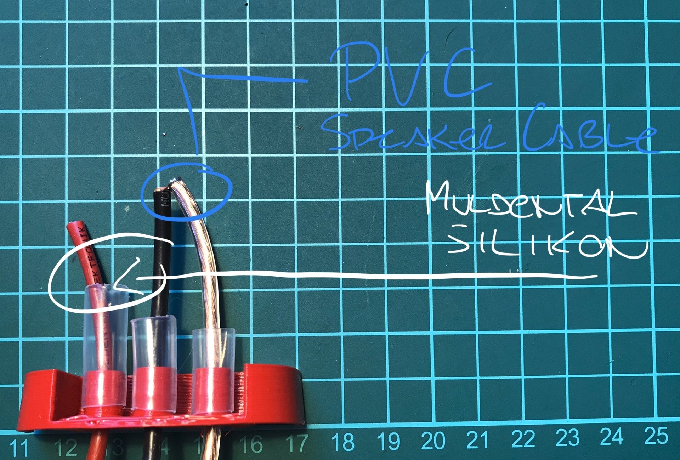
[picture p175: .gitbook/assets/cablesiliconpvc-1.jpg]
Muldental silicon cables vs. a normal cable with PVC


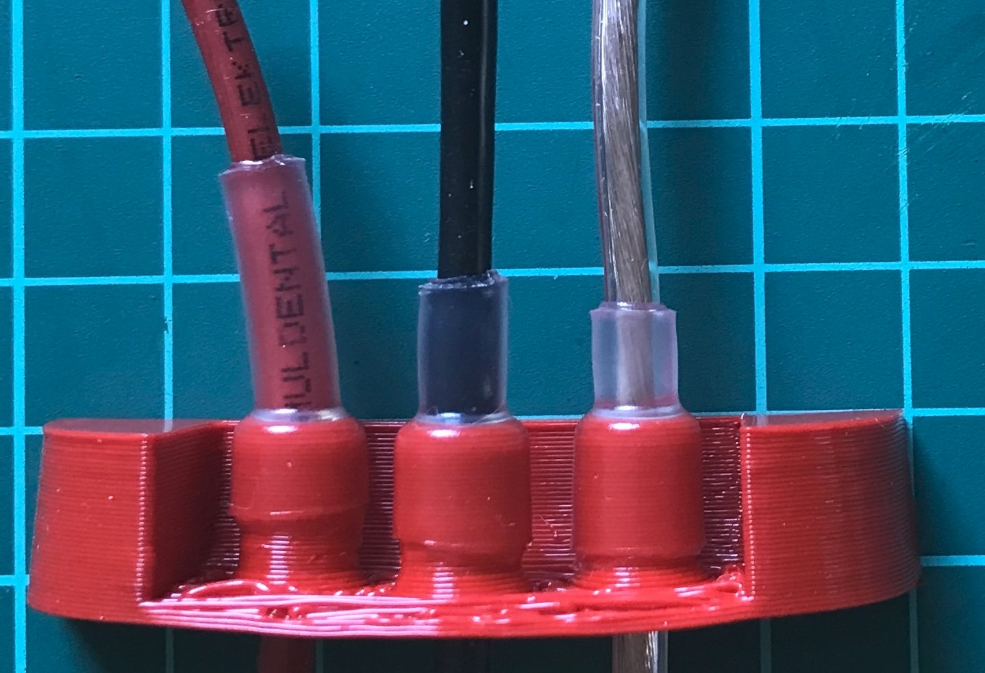
[picture p176: .gitbook/assets/cablesiliconpvc-2.jpg]
Shrinking works good on both types


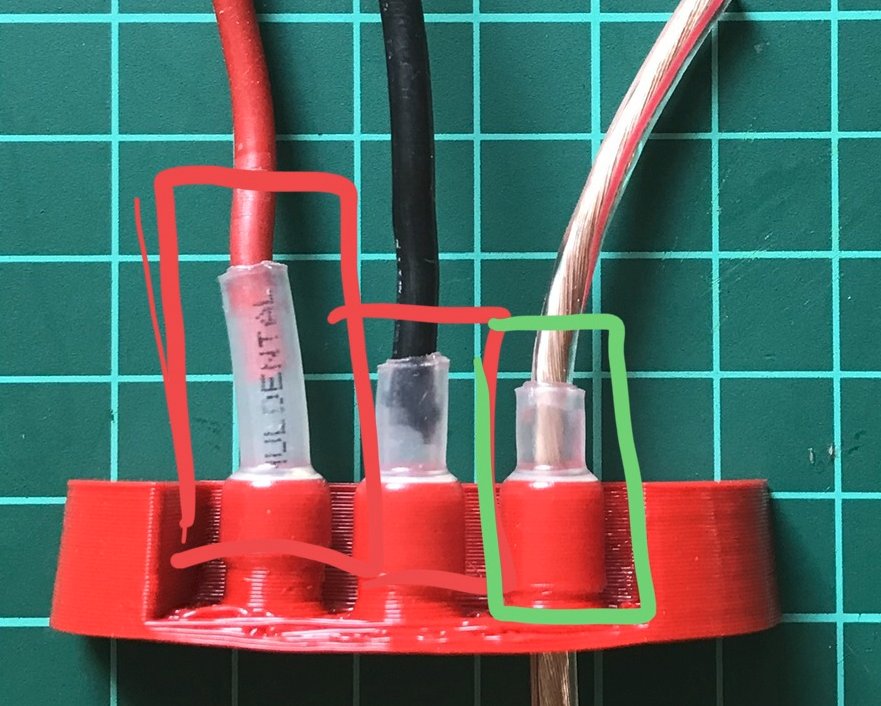
[picture p177: .gitbook/assets/cablesiliconpvc-3.jpg]
Mechanical force dis-attached the silicon cables
