KingBBQ/searchwingDronebuldingDoc/maintenance/software.md

# Software

## Change plane payload configuration

* Start "Searchwing-Manager" on Desktop

### Change Parameter

* TODO

## Update Searchwing-Software 

* Start "Searchwing-Updater" on Desktop
* TODO

## 

##
