KingBBQ/searchwingDronebuldingDoc/(list of files, drawings)

Other design files:
Photos/Schematics/wiring pixracer pi zero power.fzz
