KingBBQ/searchwingDronebuldingDoc/(commit log)

2021-07-03 - photos for acetone vapouring - more cable photos & schematics
    [wiring pixracer pi zero power.fzz]
2021-07-21 - photos for cable testing
2021-08-01 pics for wing assembly and servo stuff...
