KingBBQ/searchwingDronebuldingDoc/.gitbook/assets/Servo Pushrods 2.jpg

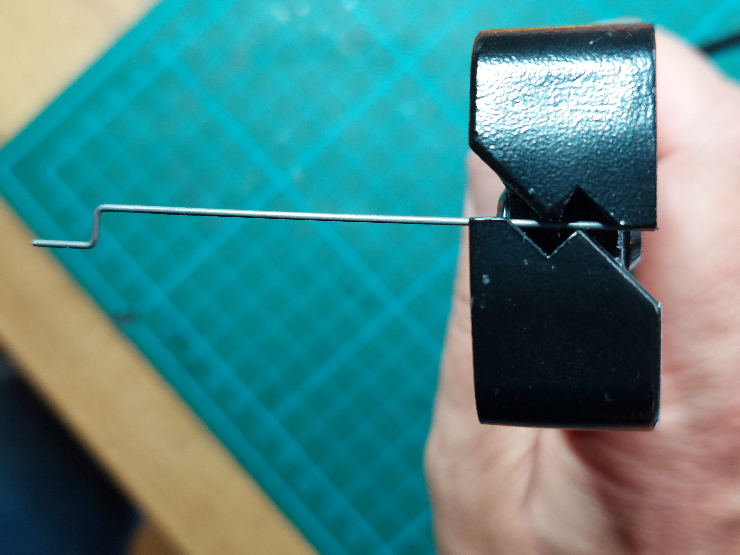
[picture p110: .gitbook/assets/servo-pushrods-2.jpg]
.gitbook/assets/Servo Pushrods 2.jpg
