KingBBQ/searchwingDronebuldingDoc/.gitbook/assets/wing-main-1.jpg

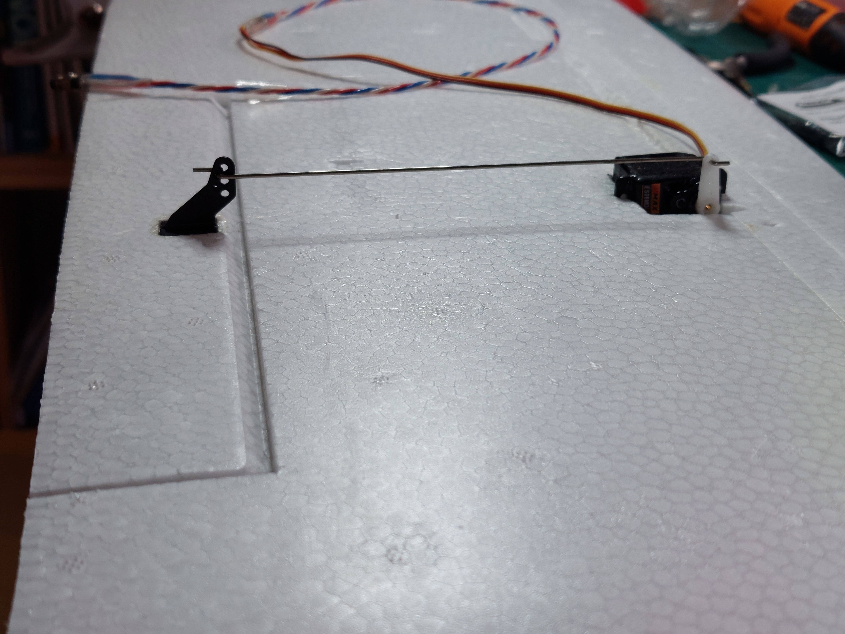
[picture p121: .gitbook/assets/wing-main-1.jpg]
.gitbook/assets/wing-main-1.jpg
