KingBBQ/searchwingDronebuldingDoc/.gitbook/assets/wing-main-2.jpg

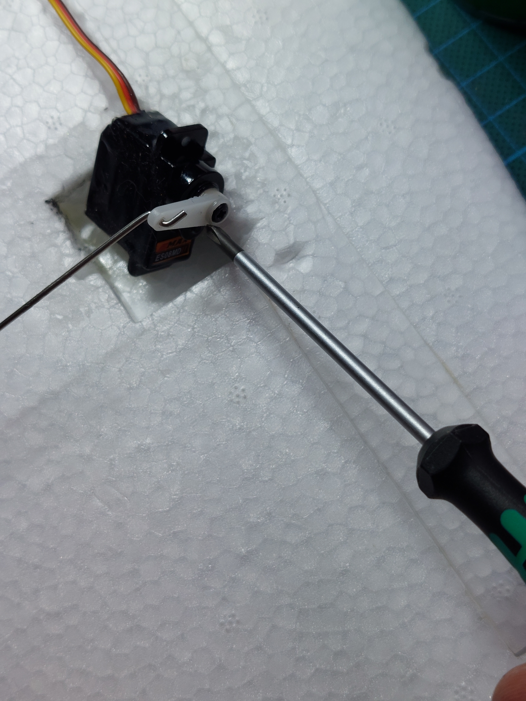
[picture p122: .gitbook/assets/wing-main-2.jpg]
.gitbook/assets/wing-main-2.jpg
