KingBBQ/searchwingDronebuldingDoc/.gitbook/assets/wing-tail-3.jpg

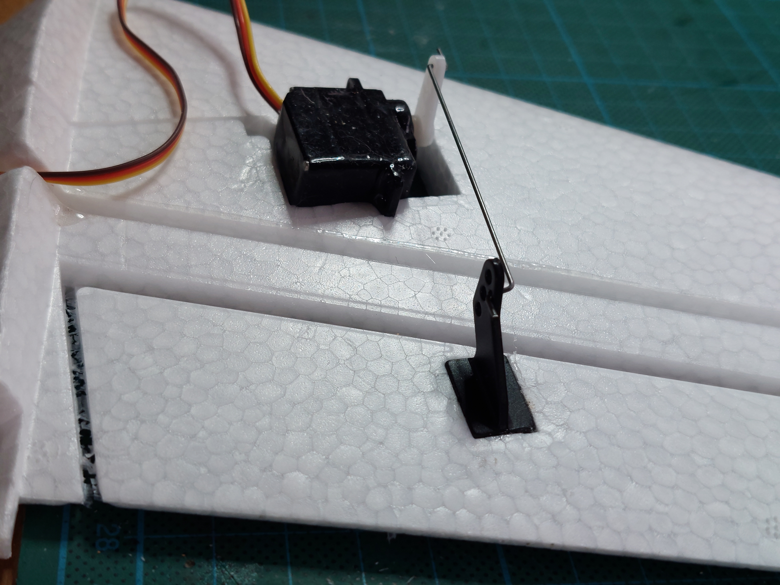
[picture p129: .gitbook/assets/wing-tail-3.jpg]
.gitbook/assets/wing-tail-3.jpg
