KingBBQ/searchwingDronebuldingDoc/.gitbook/assets/Searchwing Acetone 2.jpg

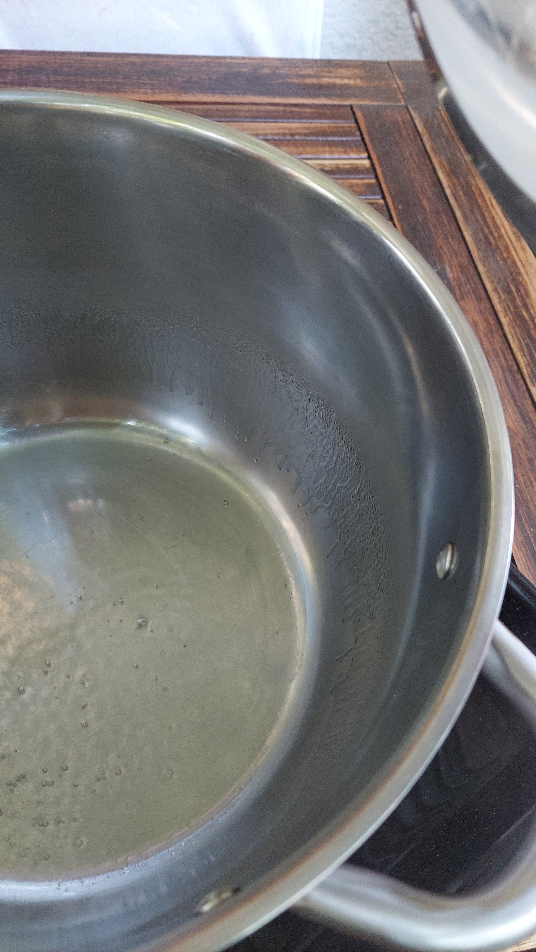
[picture p155: .gitbook/assets/searchwing-acetone-2.jpg]
.gitbook/assets/Searchwing Acetone 2.jpg
