KingBBQ/searchwingDronebuldingDoc/.gitbook/assets/Searchwing Acetone 3.jpg

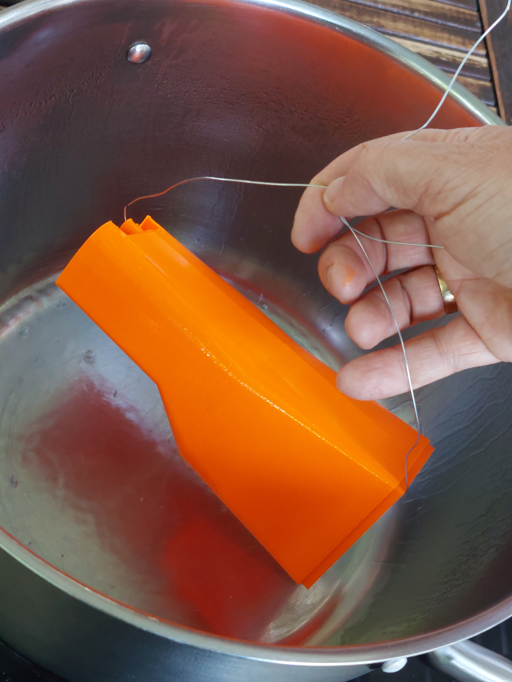
[picture p156: .gitbook/assets/searchwing-acetone-3.jpg]
.gitbook/assets/Searchwing Acetone 3.jpg
