KingBBQ/searchwingDronebuldingDoc/Photos/Assembly/Cover Antenna .jpg

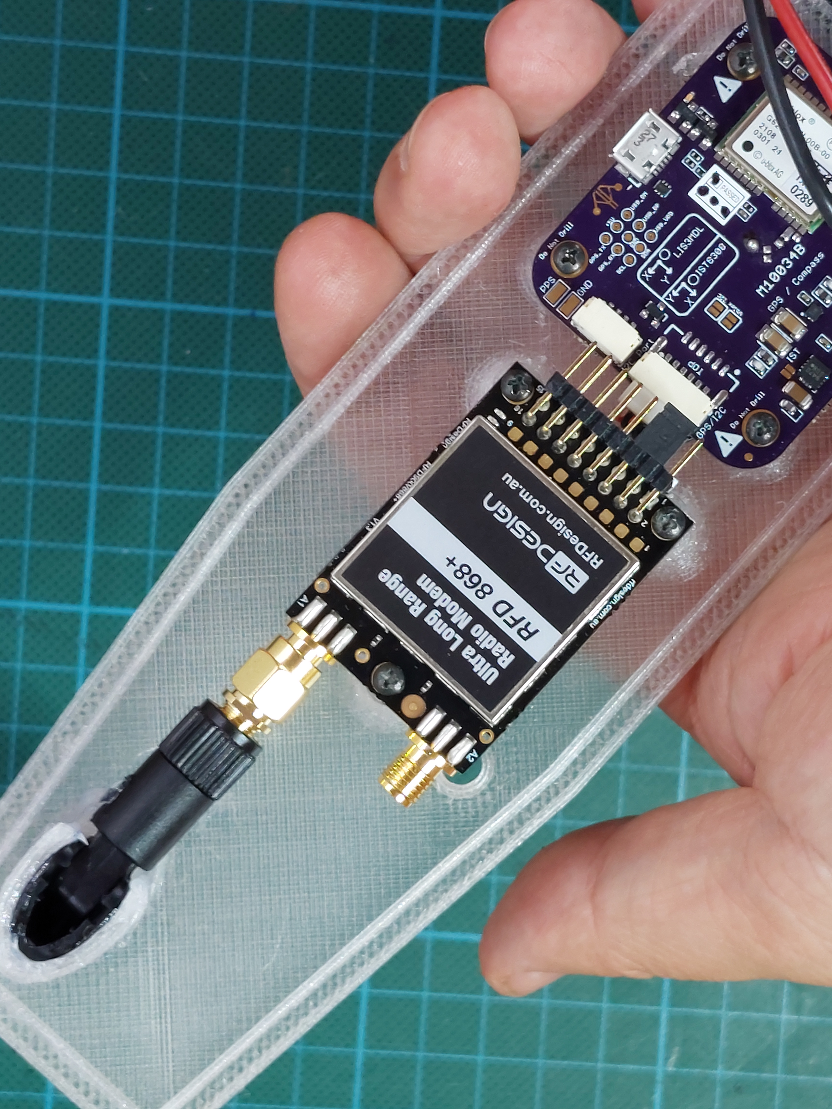
Photos/Assembly/Cover Antenna .jpg
