KingBBQ/searchwingDronebuldingDoc/Photos/Assembly/m-plug 5.jpg

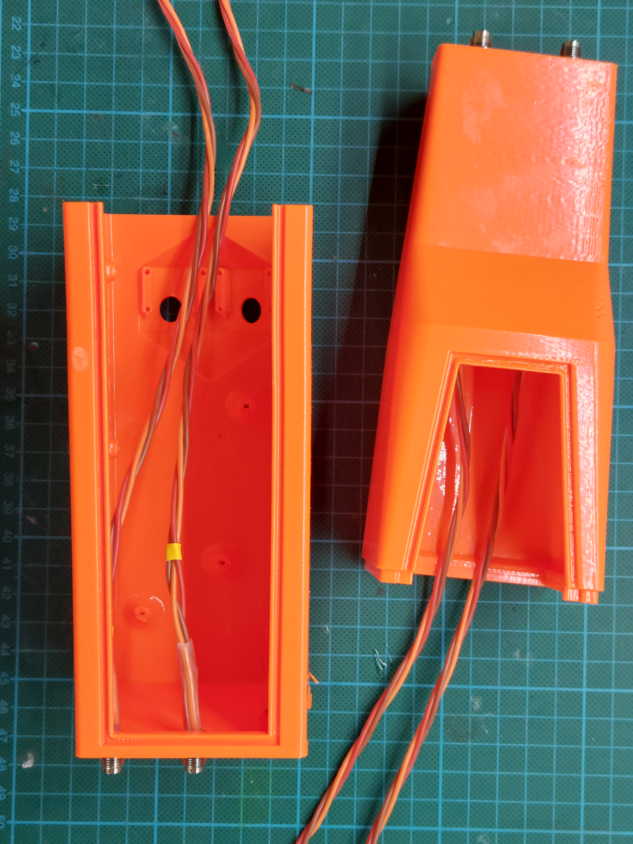
Photos/Assembly/m-plug 5.jpg
