KingBBQ/searchwingDronebuldingDoc/Photos/Assembly/Wing Tail 2.jpg

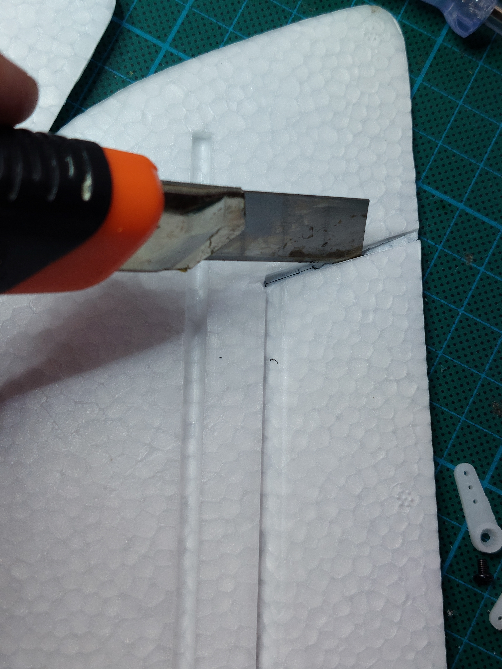
Photos/Assembly/Wing Tail 2.jpg
