KingBBQ/searchwingDronebuldingDoc/.gitbook/assets/PowerModule 1.jpg

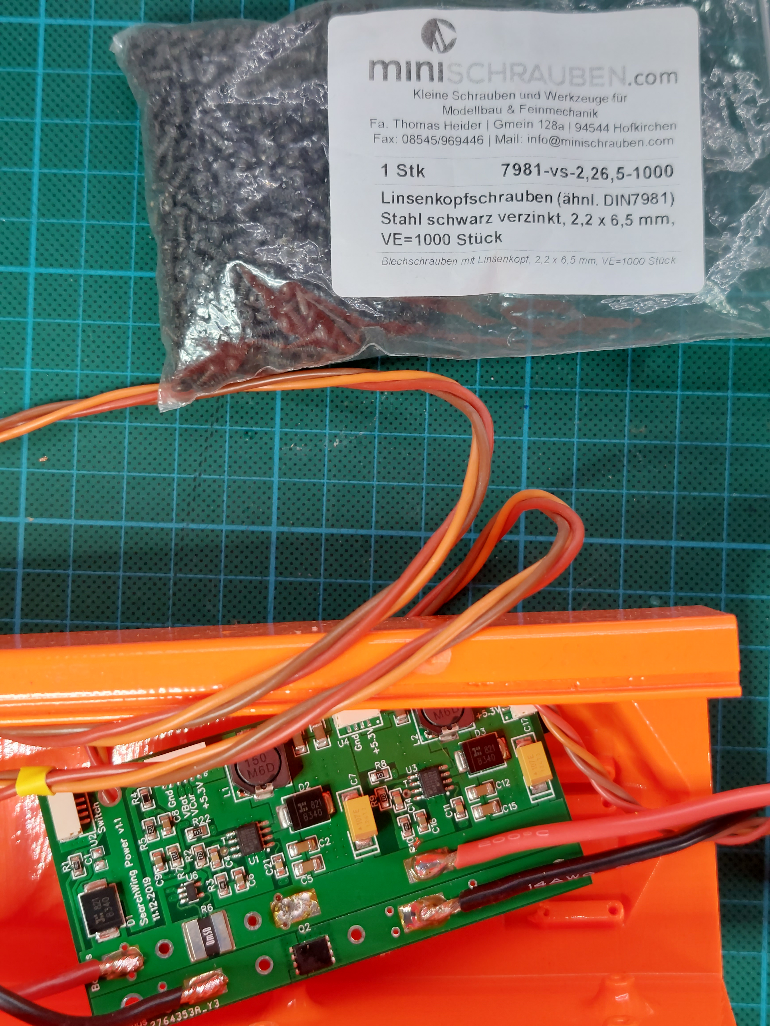
[picture p49: .gitbook/assets/powermodule-1.jpg]
.gitbook/assets/PowerModule 1.jpg
